TuanLinh05/antenna-fuzzy-control/3D Print/Antenna_TheGioiIC_v3/hardware_BOM.csv

category | item | sku | required | purchase | price | stock | minimum | multiple | url | notes | verified_date
mechanical | MG946R servo 180° + bộ tay đi kèm | IC373 | 1 | 1 | 98220 | 60 | 1 | 1 | https://www.thegioiic.com/mg946r-dong-co-servo-giam-toc-rc-180-do-rang-kim-loai-12-kg-cm-4-8-7-2-v | Thân 40×19×43 mm theo cửa hàng; dùng tay tròn và vít tâm trong bộ. Ảnh cửa hàng có các phụ kiện này; kiểm tra bộ nhận được. | 2026-10-24
mechanical | NEMA17 SL42STH40-1684A | IC5255 | 1 | 1 | 210900 | 1 | 1 | 1 | https://www.thegioiic.com/sl42sth40-1684a-dong-co-buoc-nema17-42x42mm-1-8-0-4nm | Trục Ø5, nhô 20 mm, thân dài 40 mm, 1,68 A/pha; mẫu lỗ gá 31 mm theo NEMA17 danh định. Tồn chỉ 1. | 2026-10-24
mechanical | Pulley GT2 20T, lỗ 5 mm, rãnh 7 mm | IC7387 | 1 | 1 | 11400 | 46 | 1 | 1 | https://www.thegioiic.com/gt2-banh-rang-puly-20-rang-buoc-2mm-ranh-day-dai-7mm-lo-5mm | Rãnh nhận đai 6 mm; căn giữa vùng răng tại Z=73 mm. Chiều dài dọc trục pulley chưa có bản vẽ đầy đủ. | 2026-10-24
mechanical | Dây vòng kín 2GT-280, rộng 6 mm | IC20188 | 1 | 1 | 17100 | 46 | 1 | 1 | https://www.thegioiic.com/2gt-280-day-dai-140-rang-buoc-2-0-rong-6mm | 280 mm / 140 răng / bước 2 mm. Đúng cấu hình CAD V2. | 2026-10-24
mechanical | Vòng bi 608ZZ 8×22×7 mm | IC15606 | 4 | 4 | 3420 | 1599 | 1 | 1 | https://www.thegioiic.com/608zz-bac-dan-vong-bi-trong-8mm-ngoai-22mm-day-7mm | 2 vòng bi phương vị và 2 vòng bi nâng; không đổi sang 688ZZ. | 2026-10-24
mechanical | Thanh trượt inox 304 Ø8×200 mm | IC17522 | 1 | 1 | 19753 | 49 | 1 | 1 | https://www.thegioiic.com/thanh-truot-8mm-dai-20cm-inox-304 | Cắt 120 +40 +30 mm; chừa tối đa 10 mm cho đường cắt và sửa đầu. Dũa mặt phẳng ở các vị trí truyền động theo hướng dẫn V3. | 2026-10-24
mechanical | Vít M4×20 DIN912 304 | IC10179 | 20 | 24 | 1368 | 3481 | 1 | 1 | https://www.thegioiic.com/oc-luc-giac-m4-x-20mm-din912-304 | Khung 20 vị trí, dùng lại ốc đang có nếu đúng M4x20 DIN912. Không cần mua dòng này nếu đã đủ. | 2026-10-24
mechanical | Vít M3×8 DIN912 304 | IC10152 | 4 | 10 | 650 | 3975 | 10 | 5 | https://www.thegioiic.com/oc-luc-giac-m3-x-8mm-din912-304 | Adapter ép trục 1; mặt encoder 3 kèm đệm in 1 mm, vào ren encoder 3 mm danh định. Kiểm tra chiều sâu ren thực. | 2026-10-24
mechanical | Vít M3×10 DIN912 304 | IC10153 | 6 | 10 | 673 | 16047 | 10 | 5 | https://www.thegioiic.com/oc-luc-giac-m3-x-10mm-din912-304 | Motor 4 kèm đệm in 1 mm; giá chảo ép trục 2. Tối thiểu 10, bội 5. | 2026-10-24
mechanical | Vít M3×12 DIN912 304 | IC10154 | 12 | 15 | 713 | 2150 | 10 | 5 | https://www.thegioiic.com/oc-luc-giac-m3-x-12mm-din912-304 | Chân đế 4; tai servo 4; ép trục rotor 1; hub đầu thu 3. Tối thiểu 10, bội 5. | 2026-10-24
mechanical | Vít M3×16 DIN912 304 | IC10155 | 6 | 10 | 866 | 9150 | 10 | 5 | https://www.thegioiic.com/oc-luc-giac-m3-x-16mm-din912-304 | Vòng chặn 2; gá encoder vào đế 4. | 2026-10-24
mechanical | Vít M3×20 DIN912 304 | IC10156 | 7 | 10 | 1083 | 4553 | 1 | 1 | https://www.thegioiic.com/oc-luc-giac-m3-x-20mm-din912-304 | Chảo vào giá 4; chân thanh đầu thu 3. Mua dư 3. | 2026-10-24
mechanical | Vít M2×10 DIN912 304 | IC10107 | 2 | 20 | 496 | 2280 | 20 | 10 | https://www.thegioiic.com/oc-luc-giac-m2-x-10mm-din912-304 | Ít nhất 2 lỗ đối xứng trên tay tròn servo. Tối thiểu 20, bội 10. | 2026-10-24
mechanical | Đai ốc thép M3 lục giác thường | IC9122 | 28 | 30 | 342 | 12903 | 20 | 10 | https://www.thegioiic.com/dai-oc-thep-m3 | 24 vị trí V2 +4 đai ốc dưới gá encoder. AF5.5 mm danh định. | 2026-10-24
mechanical | Đai ốc thép M4 lục giác thường | IC8318 | 20 | 30 | 388 | 363 | 20 | 10 | https://www.thegioiic.com/dai-oc-thep-m4 | AF danh định 7 mm; dày khoảng 3,2 mm. V2 không cần đai ốc mỏng. Tối thiểu 20, bội 10. | 2026-10-24
mechanical | Đai ốc đồng M2 lục giác | IC33241 | 2 | 10 | 570 | 265 | 10 | 5 | https://www.thegioiic.com/dai-oc-dong-m2 | Dùng cho adapter tay servo; CAD giả định AF 4 mm, dày ≤2,8 mm, cần đo thực. Tối thiểu 10, bội 5. | 2026-10-24
mechanical | Encoder LPD3806-600BM NPN 600P/R | IC3636 | 1 | 1 | 318060 | 123 | 1 | 1 | https://www.thegioiic.com/lpd3806-600bm-rotary-encoder-600-xung-npn-5-24vdc | Trục 6x13; thân D38; boss20x5; 3 lỗ M3 PCD28 hoặc30. Cấp5V; A/B kéo lên3.3V. Thân dài45mm là bao dự phòng, không phải kích thước nhà sản xuất. | 2026-10-24
mechanical | Khớp nối cứng D14 L25 lỗ6-8 | IC20164 | 1 | 1 | 11400 | 24 | 1 | 1 | https://www.thegioiic.com/khop-noi-truc-cung-dai-25mm-lo-truc-6-8 | Khớp đo encoder, không đỡ tải bàn xoay. Căn đồng tâm trước khi siết; vít hãm đi kèm cần kiểm tra khi nhận. | 2026-10-24
electrical | TB6600 driver stepper 42-57 4A | IC7010 | 1 | 1 | 116046 | 275 | 1 | 1 | https://www.thegioiic.com/tb6600-mach-dieu-khien-dong-co-buoc-42-57-4a | Cấp12V; chọn1/16 (3200 xung/vòng motor), bắt đầu mức dòng1.0A rồi thử tối đa1.5A theo bảng thực. Tín hiệu qua transistor, không nối3.3V trực tiếp vào opto5V. | 2026-10-24
electrical | Adapter kín 12V5A DC5525 | IC2723 | 1 | 1 | 83220 | 142 | 1 | 1 | https://www.thegioiic.com/nguon-adapter-12v-5a-dau-dc-5-5x2-5mm-dai-1m-co-led | Nguồn chính60W. Dùng jack cái5525 đúng2.5mm; đo cực tính trước khi đấu. | 2026-10-24
electrical | MP2482 module hạ áp 5V5A | IC19734 | 1 | 1 | 35340 | 292 | 1 | 1 | https://www.thegioiic.com/mp2482-mach-on-ap-5v-5a | Vào7-30V, ra5V theo cửa hàng. Nhánh servo và encoder, có tụ1000uF. 5A là mức công bố; kiểm tra sụt áp và nhiệt dưới tải thực. | 2026-10-24
electrical | 2N3904 NPN TO92 | IC2033 | 3 | 20 | 342 | 2260 | 20 | 10 | https://www.thegioiic.com/2n3904-transistor-npn-40v-0-2a-3-chan-to-92 | Ba kênh STEP, DIR, đệm servo. Tra đúng E/B/C theo datasheet ON Semiconductor; không suy ra từ hình vỏ. | 2026-10-24
electrical | Điện trở1k 1/4W 5% | IC921 | 5 | 50 | 55 | 18500 | 50 | 50 | https://www.thegioiic.com/dien-tro-1-kohm-1-4w-5-4-vong-mau | 3 điện trở base transistor; 2 nối tiếp A/B encoder. | 2026-10-24
electrical | Điện trở4k7 1/4W 5% | IC923 | 3 | 50 | 55 | 20350 | 50 | 50 | https://www.thegioiic.com/dien-tro-4-7-kohm-1-4w-5-4-vong-mau | 2 kéo A/B lên3.3V; 1 kéo tín hiệu servo lên5V. | 2026-10-24
electrical | Điện trở10k 1/4W 5% | IC925 | 3 | 50 | 55 | 10550 | 50 | 50 | https://www.thegioiic.com/dien-tro-10-kohm-1-4w-5-4-vong-mau | Base-emitter kéo xuống cho3 transistor. | 2026-10-24
electrical | Tụ hóa1000uF16V xuyên lỗ | IC4475 | 1 | 2 | 1596 | 271 | 1 | 1 | https://www.thegioiic.com/tu-hoa-1000uf-16v-8x16mm-xuyen-lo | Lắp song song5V/GND sát đầu cấp servo, đúng cực. Mua1 dự phòng. | 2026-10-24
electrical | Dây silicon18AWG đen | IC37942 | 2 | 2 | 15960 | 1706 | 1 | 1 | https://www.thegioiic.com/18awgx1-day-dien-silicon-chiu-nhiet-sieu-mem-mau-den-loai-tot | Đơn vị mét; dây GND nguồn, đi theo hình sao. | 2026-10-24
electrical | Dây silicon18AWG đỏ | IC37941 | 2 | 2 | 15960 | 372 | 1 | 1 | https://www.thegioiic.com/18awgx1-day-dien-silicon-chiu-nhiet-sieu-mem-mau-do-loai-tot | Đơn vị mét; nhánh12V/5V phân biệt và đánh dấu rõ. | 2026-10-24
electrical | PCB hàn test FR4 5x7cm | IC7157 | 1 | 1 | 6703 | 1825 | 1 | 1 | https://www.thegioiic.com/fr4-pcb-han-test-board-5x7cm-phu-xanh-1-mat | Hàn mạch đệm và phân phối tín hiệu. Nhánh công suất dùng dây đồng18AWG, không dùng pad mảnh làm đường dòng servo. | 2026-10-24
electrical | Hàng rào đực2.54mm40chân đồng mạ niken | IC22930 | 2 | 2 | 1596 | 2839 | 1 | 1 | https://www.thegioiic.com/hang-rao-duc-don-2-54mm-40-chan-1-hang-cao-11-2mm-xuyen-lo-chan-dong-ma-niken | Cắt header cho board và đầu servo. Hàn chắc các chân cấp nguồn. | 2026-10-24
electrical | Dây bẹ cái-cái30cm | IC2553 | 10 | 20 | 570 | 16880 | 10 | 10 | https://www.thegioiic.com/day-be-cai-cai-dai-30cm | Giá theo từng sợi; chỉ dùng cho tín hiệu và dòng nhỏ của MCU, không cấp dòng servo qua dây Dupont. | 2026-10-24
electrical | Jack DC5525 cái kèm domino | IC7741 | 1 | 1 | 4560 | 462 | 1 | 1 | https://www.thegioiic.com/dc5525-dau-noi-nguon-dc-cai-noi-day-kim-2-5mm-kem-domino | Khớp adapter5525; giữ lực kéo khỏi PCB, kiểm tra tiếp xúc và nhiệt khi chạy. | 2026-10-24
electrical | Domino KF128-2-V5mm10A | IC1167 | 6 | 8 | 2850 | 17832 | 1 | 1 | https://www.thegioiic.com/kf128-2-v-domino-2-chan-thang-5mm-300v-10a-han-pcb-loai-tot | Nguồn vào, nguồn5V, encoder và các đầu dây. Mua2 dự phòng. | 2026-10-24
electrical | CP2102 USB-TTL UART | IC3024 | 1 | 1 | 44460 | 578 | 1 | 1 | https://www.thegioiic.com/cp2102-mach-chuyen-doi-usb-to-ttl-uart | Nạp bằng bootloader UART hoặc ghi dữ liệu. TX/RX dùng mức3.3V; không cấp servo từ cổng này. Khi board đã cấp nguồn riêng chỉ nốiTX/RX/GND. | 2026-10-24
electrical | Ống co nhiệt4mm600V | IC2780 | 1 | 1 | 2394 | 2967 | 1 | 1 | https://www.thegioiic.com/ong-co-nhiet-4mm-600v | Đơn vị mét. Cách điện từng mối nối; dây servo cần nối dài bằng dây mềm và chừa vòng dây, không kéo căng dây300mm có sẵn. | 2026-10-24
