TuanLinh05/antenna-fuzzy-control/3D Print/Antenna_V4_MT6701/printed_parts.csv

part | quantity | X_mm | Y_mm | Z_mm | solid_volume_cm3
01_base | 1 | 208.0 | 146.0 | 8.0 | 234.034
02_azimuth_bearing_tower | 1 | 84.0 | 83.97 | 58.0 | 80.293
03_stepper_tension_bridge | 1 | 70.0 | 56.0 | 80.0 | 85.261
05_bearing_spacer | 3 | 11.5 | 11.5 | 2.0 | 0.102
04_GT2_80T_integrated_rotor | 1 | 96.0 | 95.97 | 37.0 | 88.799
07_fork_crossbeam | 1 | 208.0 | 60.0 | 8.0 | 91.831
08_right_bearing_arm | 1 | 136.0 | 60.0 | 32.0 | 88.353
09_left_bearing_arm | 1 | 136.0 | 60.0 | 32.0 | 87.312
10_LD1501MG_adjustable_carrier | 1 | 78.0 | 58.0 | 44.0 | 47.293
11_servo_horn_shaft_coupler | 1 | 36.0 | 35.99 | 18.0 | 6.959
12_parabolic_dish_160mm | 1 | 160.0 | 159.95 | 30.0 | 52.689
13_dish_cradle | 1 | 170.0 | 48.0 | 29.0 | 44.331
14_feed_strut | 3 | 75.0 | 62.0 | 8.0 | 3.747
15_feed_hub | 1 | 28.0 | 28.0 | 24.0 | 5.938
16_608_fit_coupon | 1 | 84.0 | 30.0 | 9.0 | 14.238
17_shaft_fit_coupon | 1 | 42.0 | 16.0 | 8.0 | 4.109
18_printed_split_shaft_collar | 2 | 25.0 | 24.0 | 8.0 | 3.058
19_bolted_printed_foot | 4 | 32.0 | 31.99 | 55.0 | 39.047
20_LD1501MG_mount_fit_gauge | 1 | 56.0 | 70.0 | 4.0 | 11.417
21_M3_motor_screw_washer_1mm | 4 | 8.0 | 8.0 | 1.0 | 0.042
22_MT6701_fixed_bridge | 1 | 80.0 | 64.0 | 40.0 | 40.518
24_MT6701_XYZ_carrier | 1 | 44.38 | 44.38 | 6.7 | 2.978
25_rotating_4x2_magnet_cap | 1 | 23.0 | 19.99 | 14.0 | 3.437
26_MT6701_PCB_fit_gauge | 1 | 28.0 | 28.0 | 1.0 | 0.515
27_4mm_magnet_fit_gauge | 1 | 32.0 | 15.0 | 5.0 | 2.313
28_motor_shaft_fit_gauge | 1 | 44.0 | 18.0 | 5.0 | 3.678
29_servo_ear_0p5mm_spacer | 4 | 6.2 | 6.2 | 0.5 | 0.011
30_NEMA17_mount_fit_gauge | 1 | 50.0 | 50.0 | 2.0 | 3.395
23_D_shaft_fit_gauge | 1 | 38.0 | 20.0 | 8.0 | 5.253
