TuanLinh05/antenna-fuzzy-control/Review_2026-10-24/test_matrix.csv

id | phase | test | input | measure | proposed_acceptance | status
E01 | electrical | Driver_supply | Verify_TB6600_label_and_measure_12V_bus | Driver_voltage_and_fault | 12V_within_exact_module_range_and_no_supply_droop_fault | NOT_RUN
E02 | electrical | Servo_supply | Small_moves_near_calibrated_neutral | Servo_voltage_droop_and_peak_current | Within_6_to_8p4V_and_supply_thermal_budget | NOT_RUN
I01 | identification | Motor_and_step_scale | Known_small_pulse_count_in_both_directions | Actual_angle_per_pulse_and_rotation_sign | Consistent_with_verified_step_angle_microstep_and_ratio | NOT_RUN
I02 | identification | Azimuth_MT6701_calibration | Independent_known_angle_marks_in_both_directions | Offset_scale_nonlinearity_and_repeatability | Report_calibration_error_before_tracking_claim | NOT_RUN
I03 | identification | Azimuth_backlash | Approach_same_target_from_both_directions | Output_angle_and_pulse_dead_travel | Record_measured_backlash_for_model | NOT_RUN
I04 | identification | Servo_calibration_under_load | Small_PWM_steps_with_dish_and_external_angle_reference | Final_angle_and_direction_bias_dynamic_metrics_only_if_recorded | Calibration_map_and_separate_validation_points | NOT_RUN
C01 | tracking | Azimuth_small_steps | 0_to_1_to_minus1_to_0_deg | Absolute_error_and_hunting | Final_2s_error_le_0p5deg_and_no_sustained_hunting | NOT_RUN
C02 | tracking | Azimuth_large_steps | 0_to_30_to_minus30_to_0_deg | Overshoot_Ts2percent_TsAbsolute_speed | Final_error_le_0p5deg_report_POT_target_2percent | NOT_RUN
C03 | tracking | Elevation_servo_positions | Calibrated_servo_commands_75_90_105_deg | Final_elevation_by_external_reference_NOT_PWM_as_measurement | Proposed_error_le_1deg_subject_to_reference_uncertainty | NOT_RUN
C04 | tracking | Both_axes_together | Same_targets_as_C02_C03_with_synchronized_changes | Logged_azimuth_and_external_final_elevation | Azimuth_criteria_and_external_elevation_check_no_fault | NOT_RUN
C05 | tracking | Repeated_bidirectional_targets | Repeat_same_targets_5_times | Final_error_mean_std_range_and_direction_bias | Publish_all_runs_and_max_min | NOT_RUN
C06 | comparison | Same_plant_baselines | Open_loop_or_servo_default_then_tuned_PD_then_fuzzy | Same_metrics_limits_load_and_reference | Fair_budget_no_requirement_that_fuzzy_wins | NOT_RUN
C07 | tracking | Moving_reference | Low_rate_bounded_ramp_then_sine | RMSE_phase_lag_and_speed | Set_tracking_limits_after_identification | NOT_RUN
R01 | robustness | Load_variation | Known_light_load_change_with_base_secured | Error_speed_and_current | Within_validated_mechanical_and_electrical_range | NOT_RUN
R02 | simulation | Missed_pulses | Drop_known_pulse_fraction | Recovery_error_and_fault | Report_command_loss_separately_from_rotor_slip | NOT_RUN
F01 | fault | Heartbeat_loss | Stop_heartbeat_without_reset | Time_to_fault_and_last_command | Firmware_timeout_and_motion_stop_verified | NOT_RUN
F02 | fault | Azimuth_sensor_stale_or_invalid | Inject_stale_MT6701_data_or_I2C_error_in_software | Data_age_fault_and_command_stop | Fault_within_configured_data_age_limit | NOT_RUN
F03 | fault | Out_of_range_command | Send_goal_outside_calibrated_travel | Rejection_and_no_new_motion | Reject_goal_and_preserve_defined_fault_policy | NOT_RUN
S01 | simulation | Jam_release_and_shock | Existing_jam_and_0p08Nm_simulation_only | True_peak_speed_and_tracking_failure | Observation_only_no_hardware_blocking_test | NOT_RUN
