TuanLinh05/antenna-fuzzy-control/3D Print/Antenna_TheGioiIC_v3/STEP/ASSEMBLY_with_hardware_envelopes.step

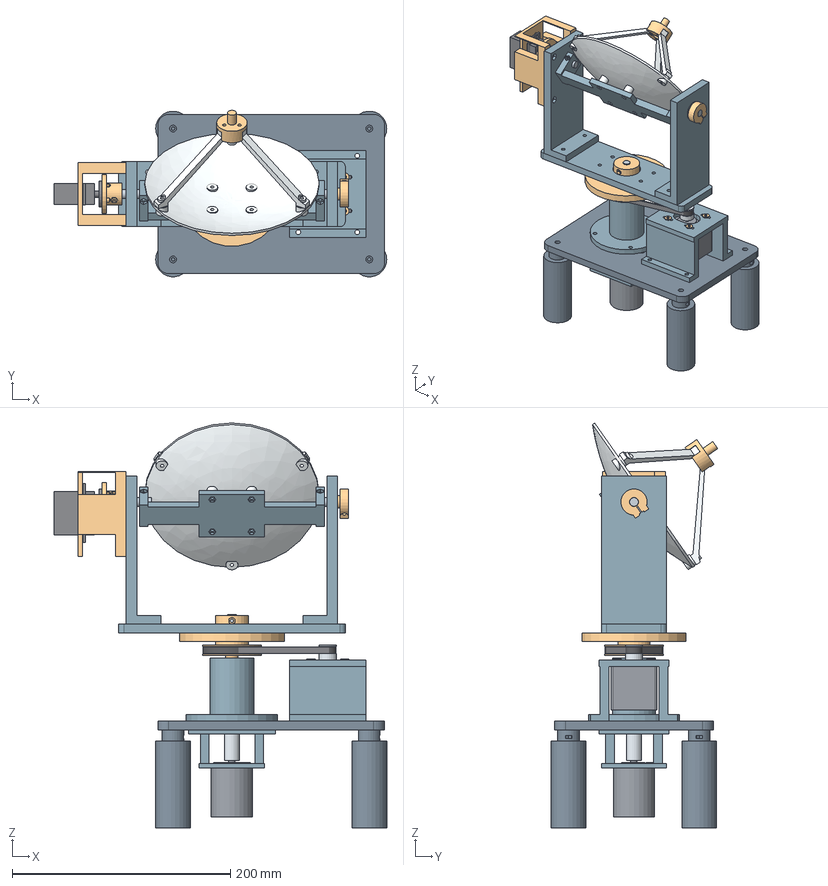
[picture p3: CAD file, 2026-10-25]
3D Print/Antenna_TheGioiIC_v3/STEP/ASSEMBLY_with_hardware_envelopes.step
305.0 x 152.7 x 371.4 mm
01_base
02_azimuth_bearing_tower
03_stepper_tension_bridge
upper_bearing_spacer
lower_bearing_spacer
right_elevation_inner_race_spacer
04_GT2_80T_integrated_rotor
07_fork_crossbeam
08_right_bearing_arm
09_left_bearing_arm
10_MG946R_short_screw_carrier
11_servo_horn_shaft_coupler
12_parabolic_dish_160mm
13_dish_cradle
feed_strut_90
feed_strut_210
feed_strut_330
15_feed_hub
printed_azimuth_lower_collar
printed_right_elevation_collar
printed_foot_-54_-60
printed_foot_-54_60
printed_foot_126_-60
printed_foot_126_60
motor_screw_washer_-15.5_-15.5
motor_screw_washer_-15.5_15.5
motor_screw_washer_15.5_-15.5
motor_screw_washer_15.5_15.5
22_output_encoder_bracket
encoder_screw_washer_90
encoder_screw_washer_210
encoder_screw_washer_330
608_az_8
608_az_59
azimuth_8mm_shaft_120mm_D_flat
608_elevation_-97
608_elevation_90
left_8mm_shaft_40mm_D_flats
right_8mm_shaft_30mm_D_flat
LPD3806_600BM_clearance_envelope
D14L25_6_8_encoder_coupling_envelope
SL42STH40_1684A_envelope
GT2_20T_metal_pulley_ENVELOPE
MG946R_nominal_envelope
MG946R_supplied_round_horn_envelope
GT2_280mm_belt_PITCH_ENVELOPE
