TuanLinh05/antenna-fuzzy-control/3D Print/Antenna_TheGioiIC_v3/3MF_plates/Plate_05_encoder_and_D_shaft_gauge.3mf

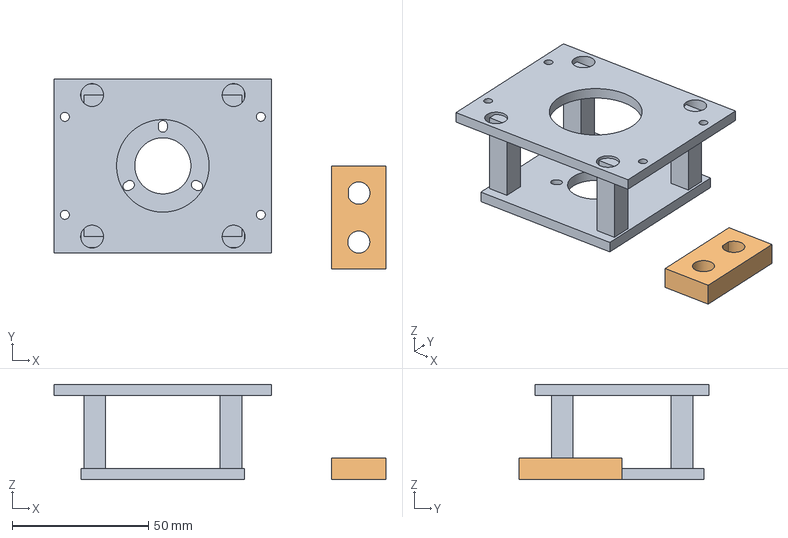
[picture p6: CAD file, 2026-10-25]
3D Print/Antenna_TheGioiIC_v3/3MF_plates/Plate_05_encoder_and_D_shaft_gauge.3mf
122.0 x 70.0 x 35.0 mm
22_output_encoder_bracket
23_D_shaft_fit_gauge
