TuanLinh05/antenna-fuzzy-control/3D Print/Antenna_TheGioiIC_v3/STEP/04_GT2_80T_integrated_rotor.step

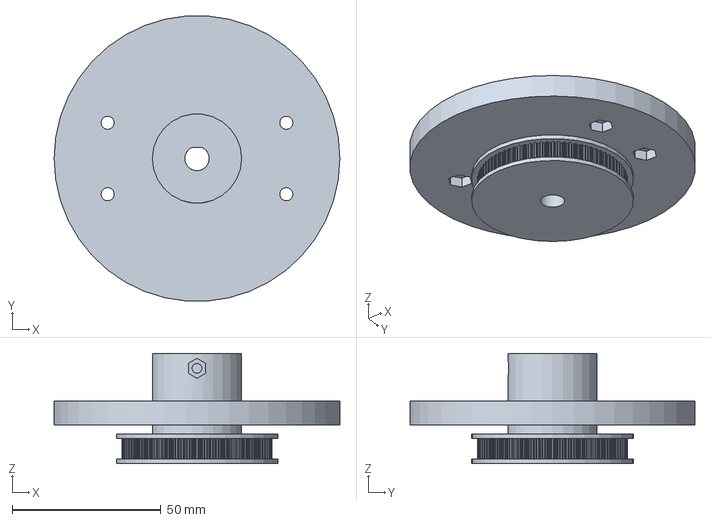
[picture p7: CAD file, 2026-10-25]
3D Print/Antenna_TheGioiIC_v3/STEP/04_GT2_80T_integrated_rotor.step
96.0 x 95.7 x 37.0 mm
