TuanLinh05/antenna-fuzzy-control/3D Print/Antenna_V4_MT6701/3MF_plates/Plate_02_dish_cradle_feed_arms.3mf

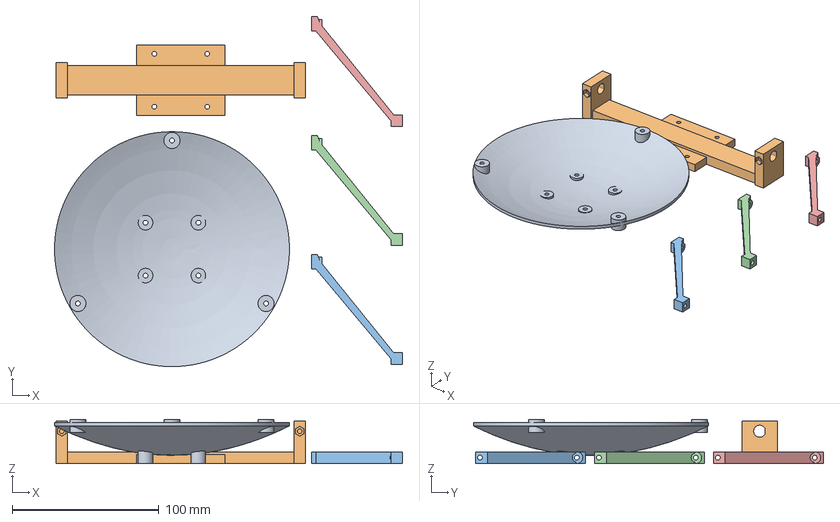
[picture p8: CAD file, 2026-10-25]
3D Print/Antenna_V4_MT6701/3MF_plates/Plate_02_dish_cradle_feed_arms.3mf
237.0 x 238.5 x 30.0 mm
12_parabolic_dish_160mm
13_dish_cradle
14_feed_strut x 3
