TuanLinh05/antenna-fuzzy-control/3D Print/Antenna_V4_MT6701/STEP/01_base.step

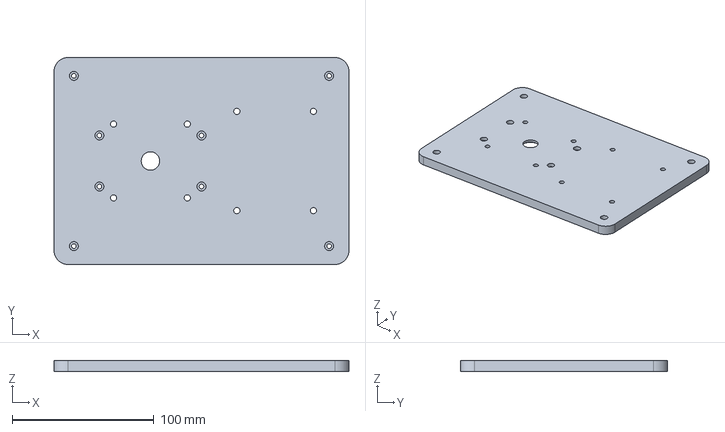
[picture p9: CAD file, 2026-10-25]
3D Print/Antenna_V4_MT6701/STEP/01_base.step
208.0 x 146.0 x 8.00 mm
