TuanLinh05/antenna-fuzzy-control/3D Print/Antenna_V5_Reinforced/3MF_A1_PETG_0p4/Plate_03_drive_and_servo_mounts_A1_PETG_0p4.3mf

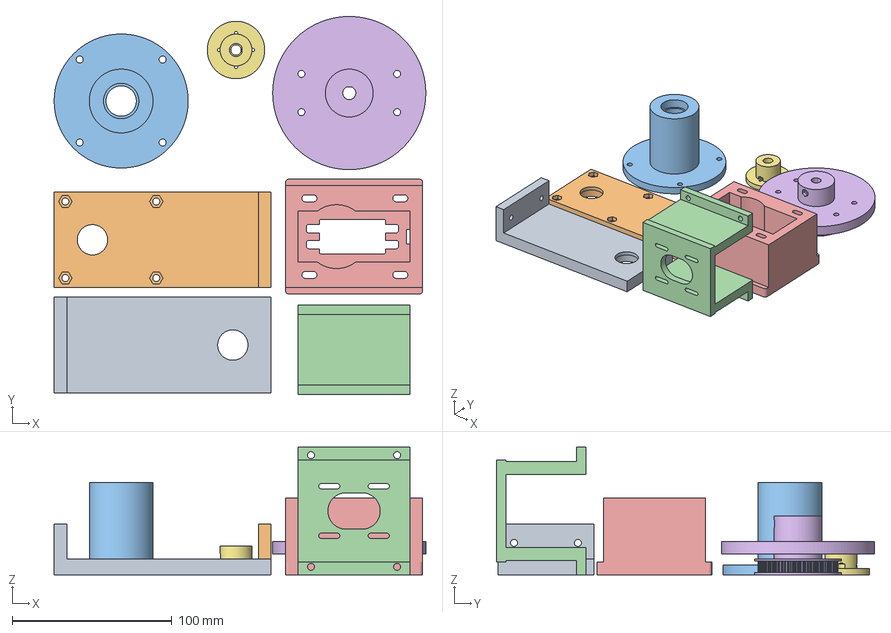
[picture p10: CAD file, 2026-10-25]
3D Print/Antenna_V5_Reinforced/3MF_A1_PETG_0p4/Plate_03_drive_and_servo_mounts_A1_PETG_0p4.3mf
233.0 x 237.0 x 80.0 mm
08_right_bearing_arm
09_left_bearing_arm
02_azimuth_bearing_tower
03_stepper_tension_bridge
10_LD1501MG_reinforced_carrier
04_GT2_80T_integrated_rotor
11_servo_horn_shaft_coupler
