TuanLinh05/antenna-fuzzy-control/3D Print/Antenna_V5_Reinforced/reference/V4_servo_carrier.step

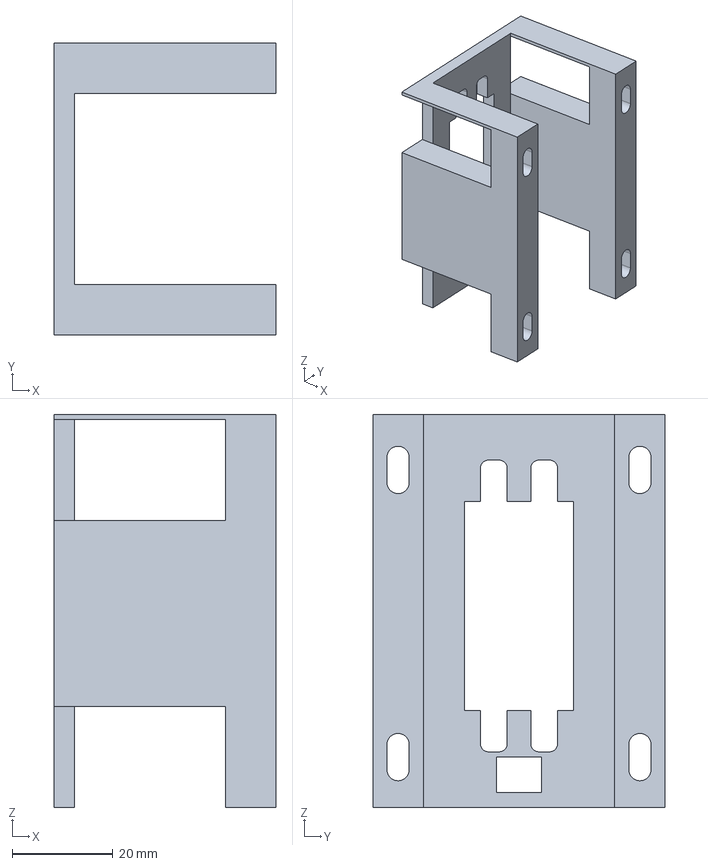
[picture p11: CAD file, 2026-10-25]
3D Print/Antenna_V5_Reinforced/reference/V4_servo_carrier.step
44.0 x 58.0 x 78.0 mm
