TuanLinh05/antenna-fuzzy-control/3D Print/Antenna_V5_Reinforced/STEP/23_D_shaft_fit_gauge.step

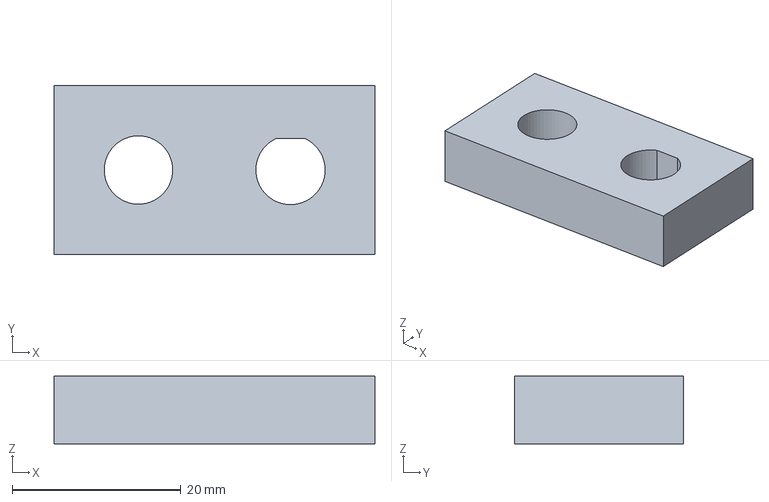
[picture p12: CAD file, 2026-10-25]
3D Print/Antenna_V5_Reinforced/STEP/23_D_shaft_fit_gauge.step
38.0 x 20.0 x 8.00 mm
