TuanLinh05/antenna-fuzzy-control/3D Print/de-mt6701-lap-thu-v1.3mf

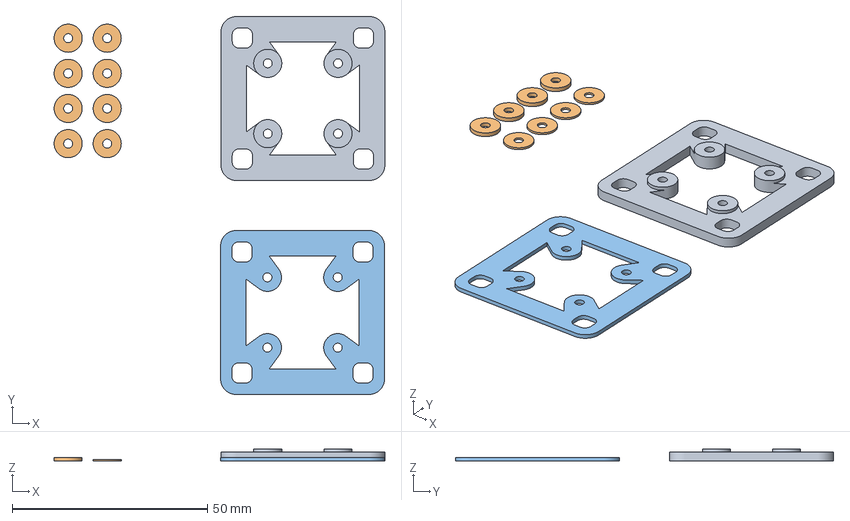
[picture p13: CAD file, 2026-10-25]
3D Print/de-mt6701-lap-thu-v1.3mf
84.7 x 96.8 x 3.20 mm
de-mt6701-lap-thu-v1.stl
dem-0p5-va-1mm-4-bo.stl
duong-kiem-lo-1mm.stl
