TuanLinh05/antenna-fuzzy-control/3D Print/Antenna_TheGioiIC_v3/3MF_plates/Plate_01_base_crossbeam.3mf

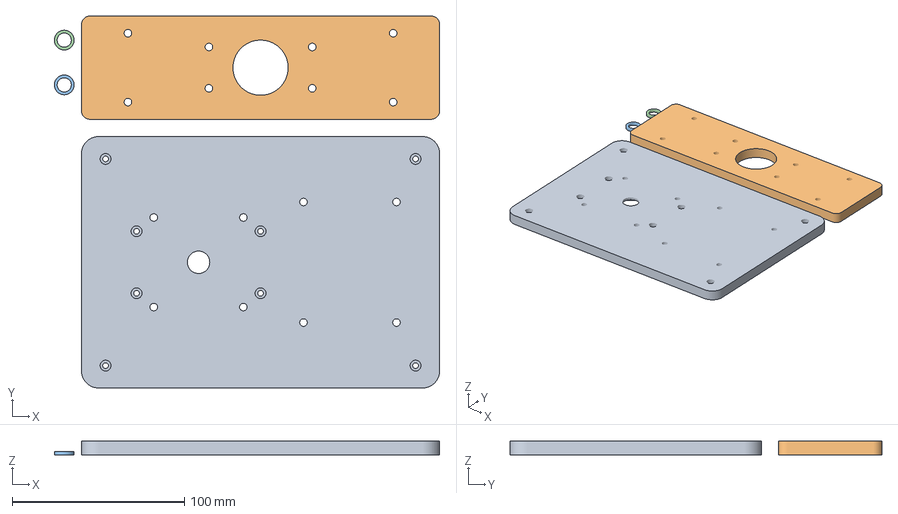
[picture p14: CAD file, 2026-10-25]
3D Print/Antenna_TheGioiIC_v3/3MF_plates/Plate_01_base_crossbeam.3mf
223.8 x 216.0 x 8.00 mm
01_base
07_fork_crossbeam
05_bearing_spacer x 2
