TuanLinh05/antenna-fuzzy-control/3D Print/Antenna_TheGioiIC_v3/STEP/15_feed_hub.step

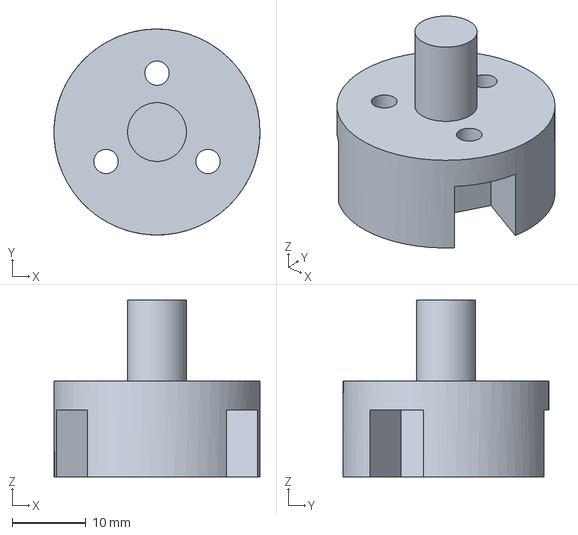
[picture p15: CAD file, 2026-10-25]
3D Print/Antenna_TheGioiIC_v3/STEP/15_feed_hub.step
28.0 x 28.0 x 24.0 mm
