TuanLinh05/antenna-fuzzy-control/3D Print/Antenna_V4_MT6701/3MF_plates/Plate_04_fit_test_and_feed_hub.3mf

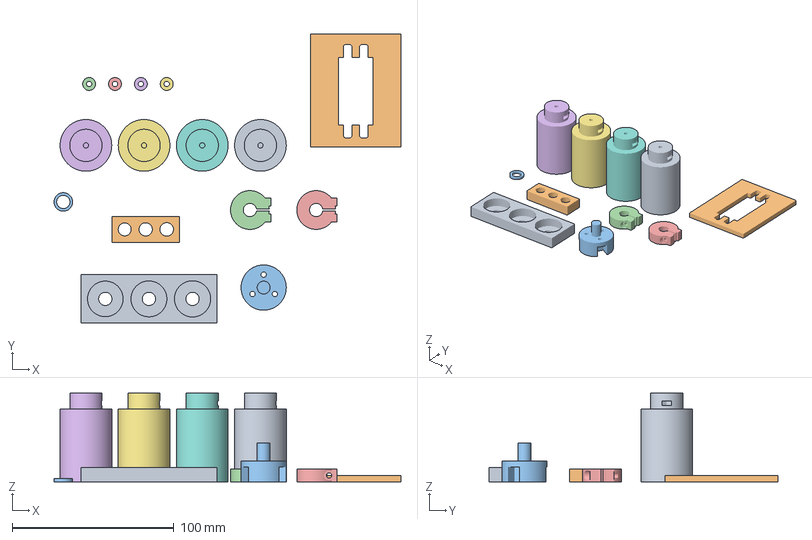
[picture p16: CAD file, 2026-10-25]
3D Print/Antenna_V4_MT6701/3MF_plates/Plate_04_fit_test_and_feed_hub.3mf
214.8 x 179.0 x 55.0 mm
16_608_fit_coupon
17_shaft_fit_coupon
15_feed_hub
18_printed_split_shaft_collar x 2
19_bolted_printed_foot x 4
20_LD1501MG_mount_fit_gauge
05_bearing_spacer
21_M3_motor_screw_washer_1mm x 4
