TuanLinh05/antenna-fuzzy-control/3D Print/Antenna_V4_MT6701/STEP/29_servo_ear_0p5mm_spacer.step

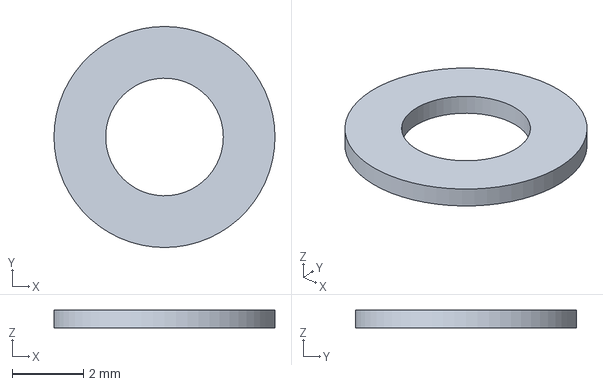
[picture p17: CAD file, 2026-10-25]
3D Print/Antenna_V4_MT6701/STEP/29_servo_ear_0p5mm_spacer.step
6.20 x 6.20 x 0.5 mm
