TuanLinh05/antenna-fuzzy-control/3D Print/Antenna_V5_Reinforced/3MF_A1_PETG_0p4/Plate_04_fit_test_and_feed_hub_A1_PETG_0p4.3mf

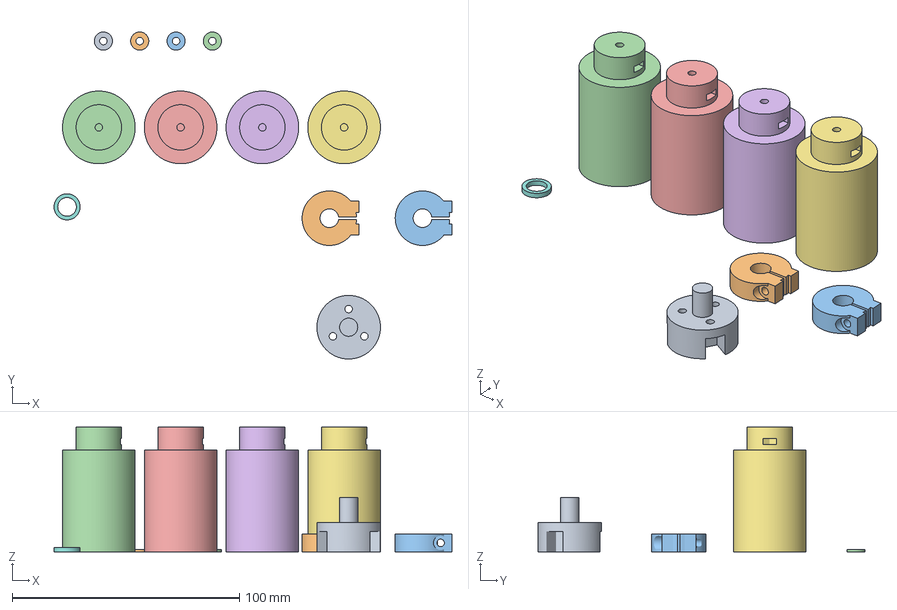
[picture p18: CAD file, 2026-10-25]
3D Print/Antenna_V5_Reinforced/3MF_A1_PETG_0p4/Plate_04_fit_test_and_feed_hub_A1_PETG_0p4.3mf
175.2 x 144.0 x 55.0 mm
15_feed_hub
18_printed_split_shaft_collar x 2
19_bolted_printed_foot x 4
05_bearing_spacer
21_M3_motor_screw_washer_1mm x 4
