TuanLinh05/antenna-fuzzy-control/3D Print/Antenna_V5_Reinforced/STEP/17_shaft_fit_coupon.step

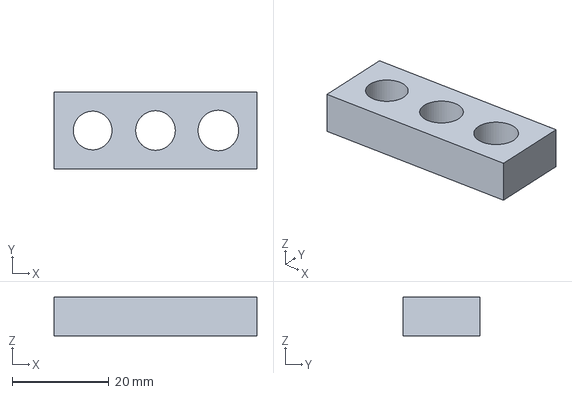
[picture p20: CAD file, 2026-10-25]
3D Print/Antenna_V5_Reinforced/STEP/17_shaft_fit_coupon.step
42.0 x 16.0 x 8.00 mm
