TuanLinh05/antenna-fuzzy-control/3D Print/duong-lo-bo-v2-1mm.3mf

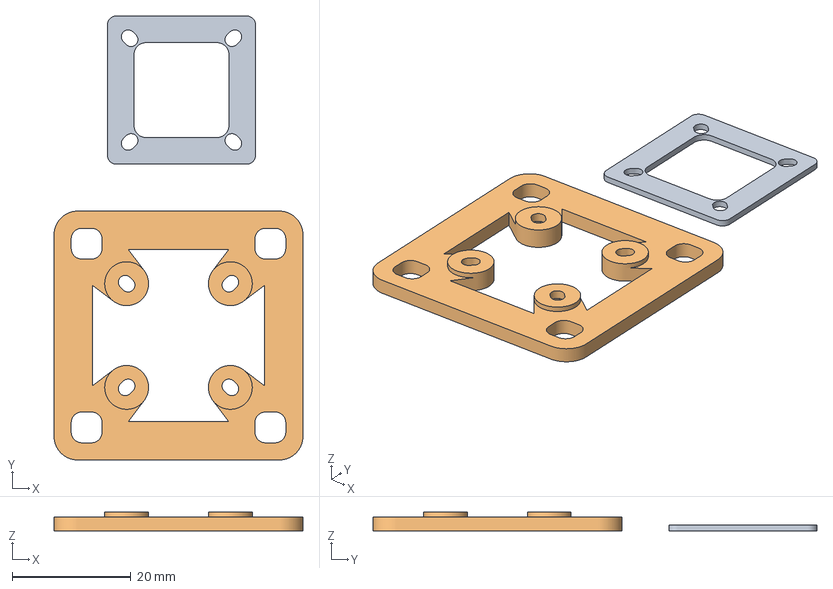
[picture p21: CAD file, 2026-10-25]
3D Print/duong-lo-bo-v2-1mm.3mf
42.0 x 74.9 x 3.20 mm
duong-lo-bo-v2-1mm.stl
de-mt6701-v2-lo-bo-chinh.stl
