TuanLinh05/antenna-fuzzy-control/3D Print/Antenna_TheGioiIC_v3/STEP/18_printed_split_shaft_collar.step

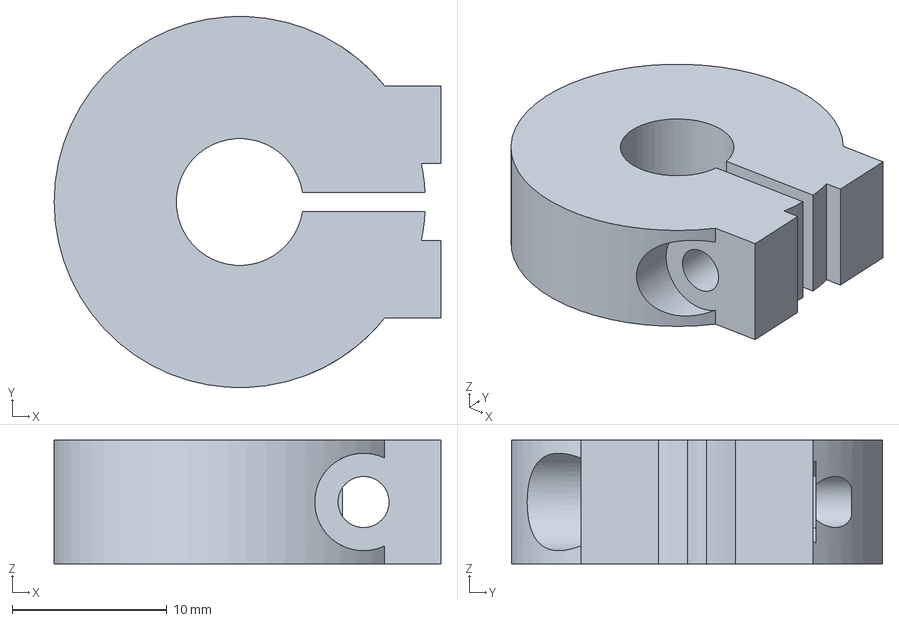
[picture p23: CAD file, 2026-10-25]
3D Print/Antenna_TheGioiIC_v3/STEP/18_printed_split_shaft_collar.step
25.0 x 24.0 x 8.00 mm
