TuanLinh05/antenna-fuzzy-control/3D Print/Antenna_V4_MT6701/STEP/26_MT6701_PCB_fit_gauge.step

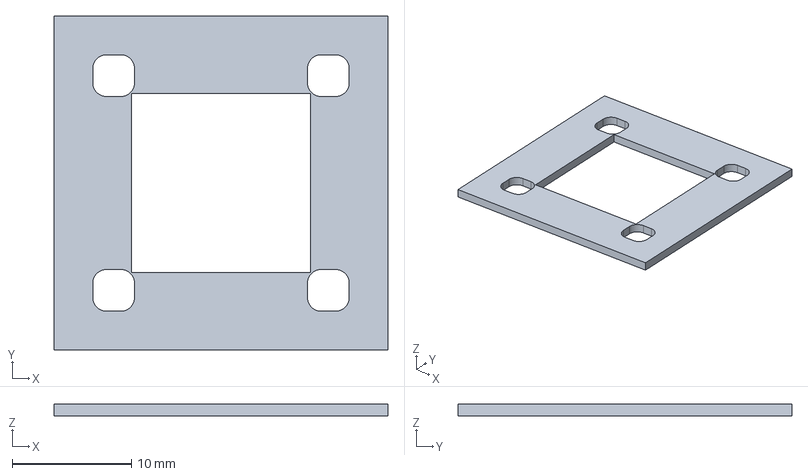
[picture p24: CAD file, 2026-10-25]
3D Print/Antenna_V4_MT6701/STEP/26_MT6701_PCB_fit_gauge.step
28.0 x 28.0 x 1.00 mm
