TuanLinh05/antenna-fuzzy-control/3D Print/Antenna_V5_Reinforced/3MF_A1_PETG_0p4/Plate_05_MT6701_and_fit_gauges_A1_PETG_0p4.3mf

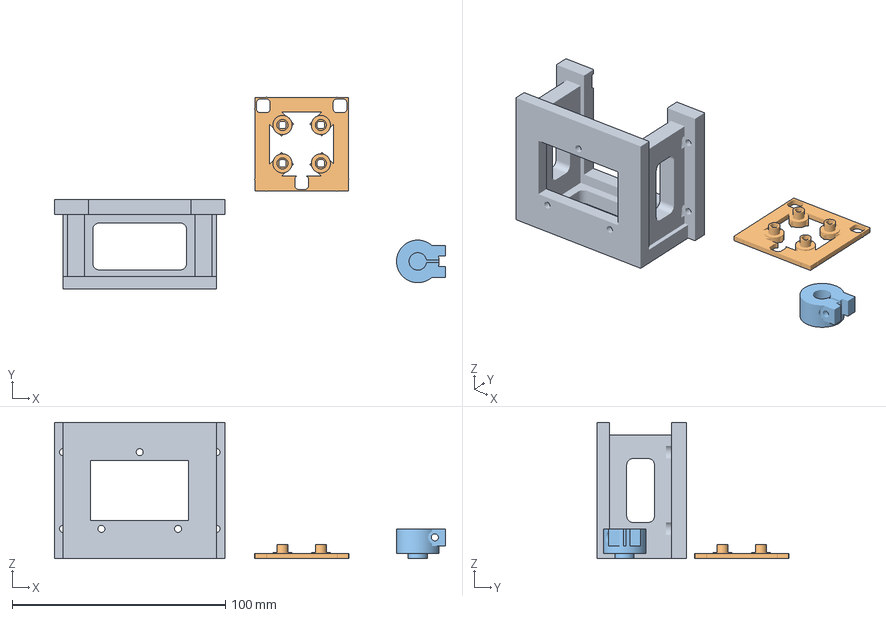
[picture p25: CAD file, 2026-10-25]
3D Print/Antenna_V5_Reinforced/3MF_A1_PETG_0p4/Plate_05_MT6701_and_fit_gauges_A1_PETG_0p4.3mf
183.5 x 90.2 x 64.0 mm
22_MT6701_open_U_bridge
24_MT6701_3point_carrier
25_rotating_4x2_magnet_cap
