TuanLinh05/antenna-fuzzy-control/3D Print/Antenna_V5_Reinforced/STEP/22_MT6701_open_U_bridge.step

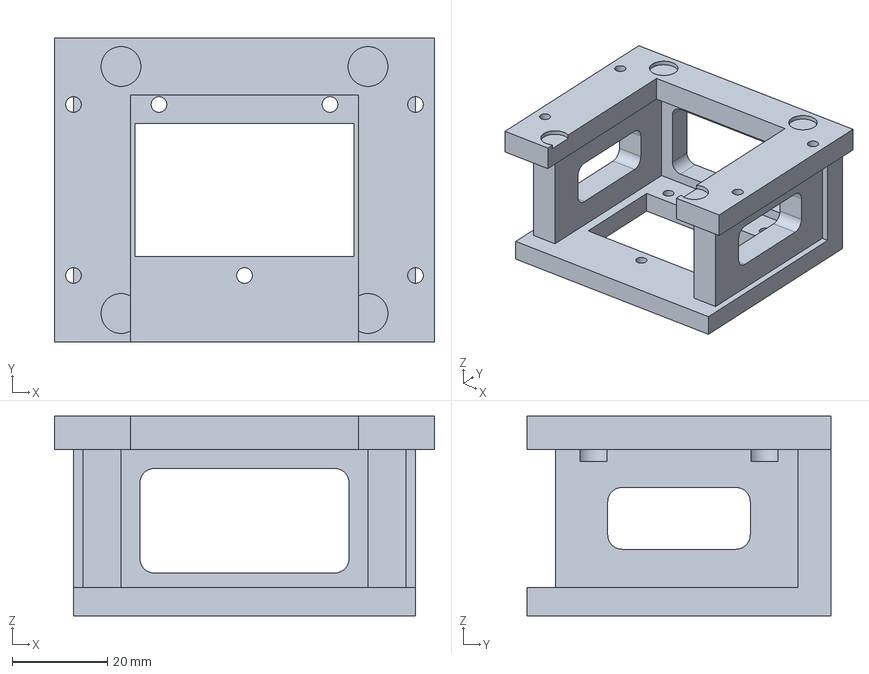
[picture p26: CAD file, 2026-10-25]
3D Print/Antenna_V5_Reinforced/STEP/22_MT6701_open_U_bridge.step
80.0 x 64.0 x 42.0 mm
