TuanLinh05/antenna-fuzzy-control/3D Print/Antenna_V4_MT6701/3MF_plates/Plate_05_MT6701_and_fit_gauges.3mf

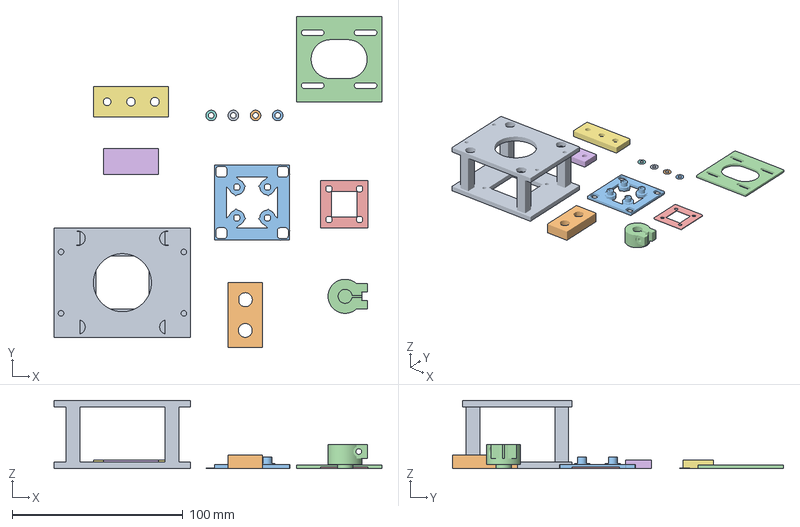
[picture p28: CAD file, 2026-10-25]
3D Print/Antenna_V4_MT6701/3MF_plates/Plate_05_MT6701_and_fit_gauges.3mf
192.0 x 194.0 x 40.0 mm
22_MT6701_fixed_bridge
23_D_shaft_fit_gauge
24_MT6701_XYZ_carrier
25_rotating_4x2_magnet_cap
26_MT6701_PCB_fit_gauge
27_4mm_magnet_fit_gauge
28_motor_shaft_fit_gauge
29_servo_ear_0p5mm_spacer x 4
30_NEMA17_mount_fit_gauge
