TuanLinh05/antenna-fuzzy-control/3D Print/Antenna_V4_MT6701/STEP/03_stepper_tension_bridge.step

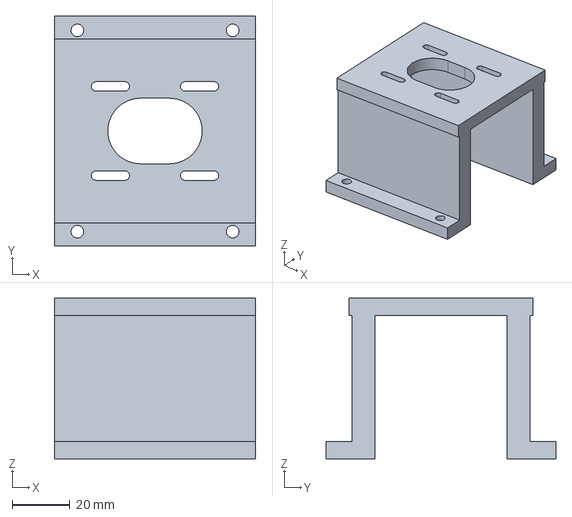
[picture p29: CAD file, 2026-10-25]
3D Print/Antenna_V4_MT6701/STEP/03_stepper_tension_bridge.step
70.0 x 80.0 x 56.0 mm
