TuanLinh05/antenna-fuzzy-control/3D Print/Antenna_V5_Reinforced/STEP/24_MT6701_3point_carrier.step

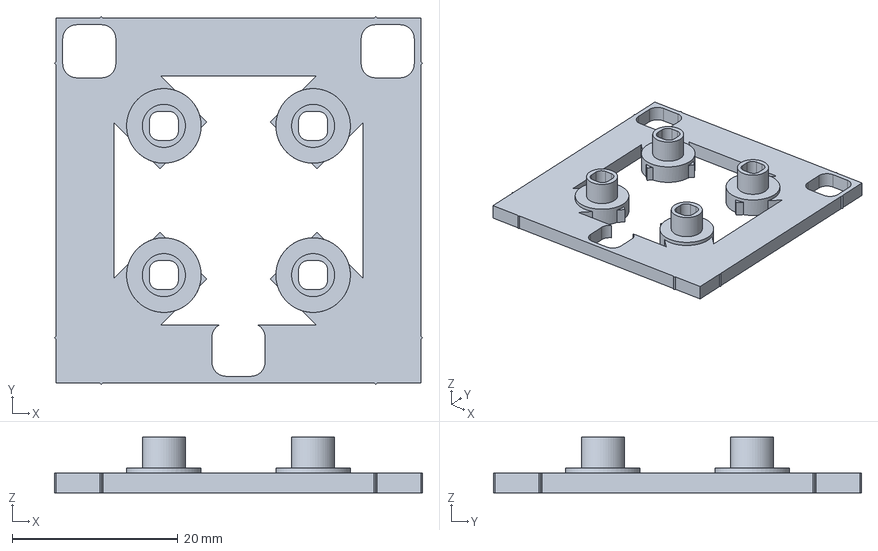
[picture p30: CAD file, 2026-10-25]
3D Print/Antenna_V5_Reinforced/STEP/24_MT6701_3point_carrier.step
44.4 x 44.4 x 6.70 mm
