TuanLinh05/antenna-fuzzy-control/3D Print/Antenna_V4_MT6701/STEP/09_left_bearing_arm.step

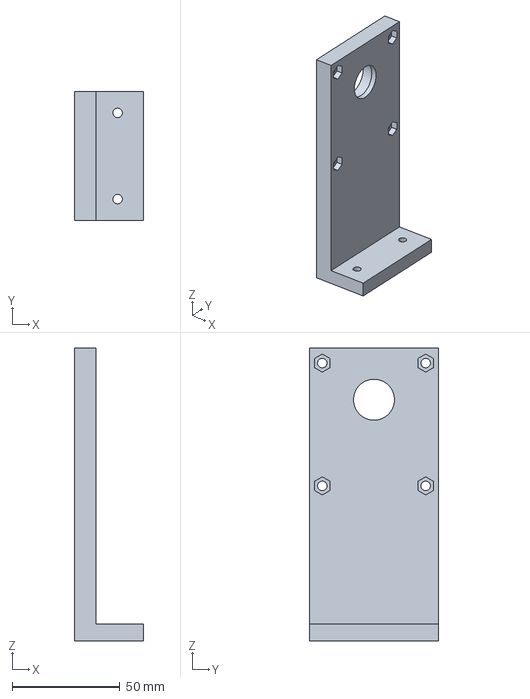
[picture p31: CAD file, 2026-10-25]
3D Print/Antenna_V4_MT6701/STEP/09_left_bearing_arm.step
32.0 x 60.0 x 136.0 mm
