TuanLinh05/antenna-fuzzy-control/3D Print/Antenna_V5_Reinforced/3MF_A1_PETG_0p4/Plate_00_CALIBRATION_FIRST_A1_PETG_0p4.3mf

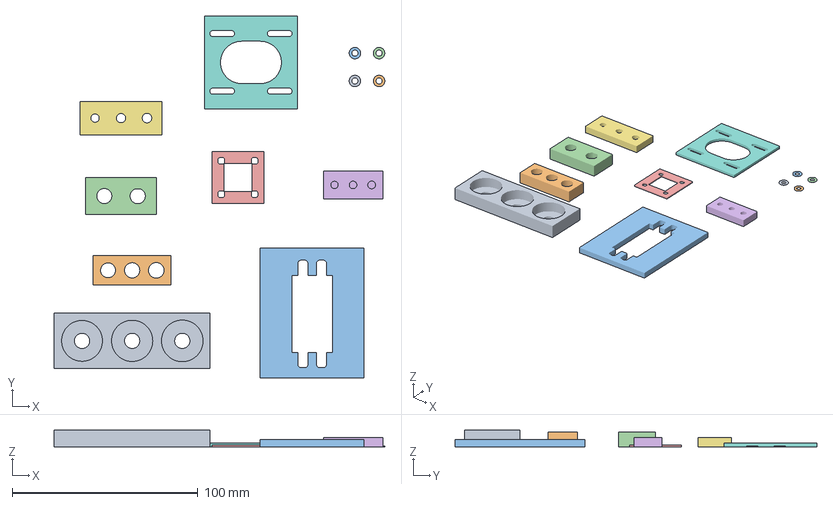
[picture p32: CAD file, 2026-10-25]
3D Print/Antenna_V5_Reinforced/3MF_A1_PETG_0p4/Plate_00_CALIBRATION_FIRST_A1_PETG_0p4.3mf
178.1 x 195.0 x 9.00 mm
16_608_fit_coupon
17_shaft_fit_coupon
20_LD1501MG_mount_fit_gauge
23_D_shaft_fit_gauge
26_MT6701_PCB_fit_gauge
27_4mm_magnet_fit_gauge
28_motor_shaft_fit_gauge
30_NEMA17_mount_fit_gauge
29_servo_ear_0p5mm_spacer x 4
