TuanLinh05/antenna-fuzzy-control/3D Print/Antenna_V5_Reinforced/STEP/05_bearing_spacer.step

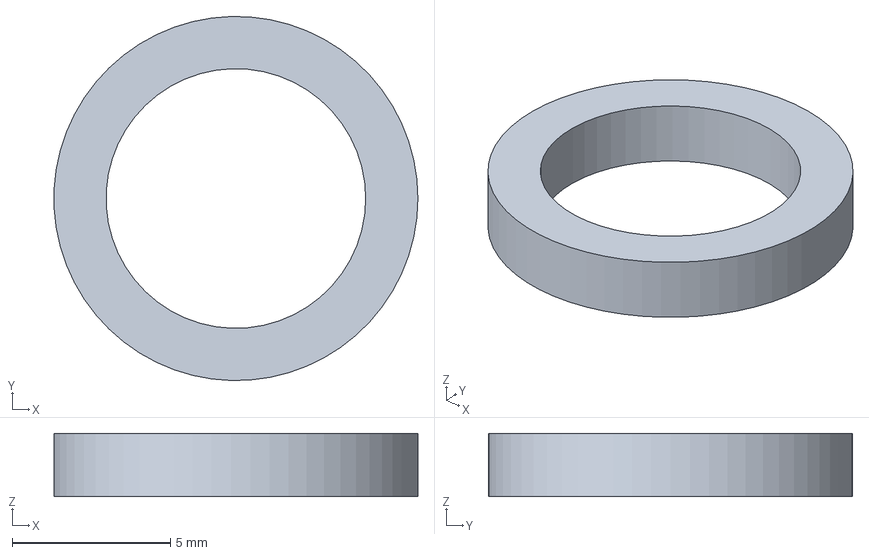
[picture p33: CAD file, 2026-10-25]
3D Print/Antenna_V5_Reinforced/STEP/05_bearing_spacer.step
11.5 x 11.5 x 2.00 mm
