TuanLinh05/antenna-fuzzy-control/3D Print/Antenna_V4_MT6701/STEP/14_feed_strut.step

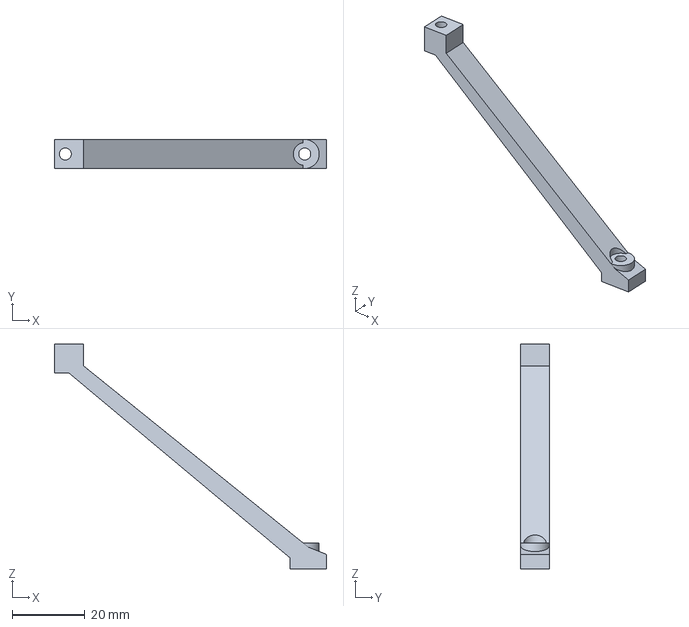
[picture p34: CAD file, 2026-10-25]
3D Print/Antenna_V4_MT6701/STEP/14_feed_strut.step
75.0 x 8.00 x 62.0 mm
