TuanLinh05/antenna-fuzzy-control/3D Print/Antenna_TheGioiIC_v3/STEP/07_fork_crossbeam.step

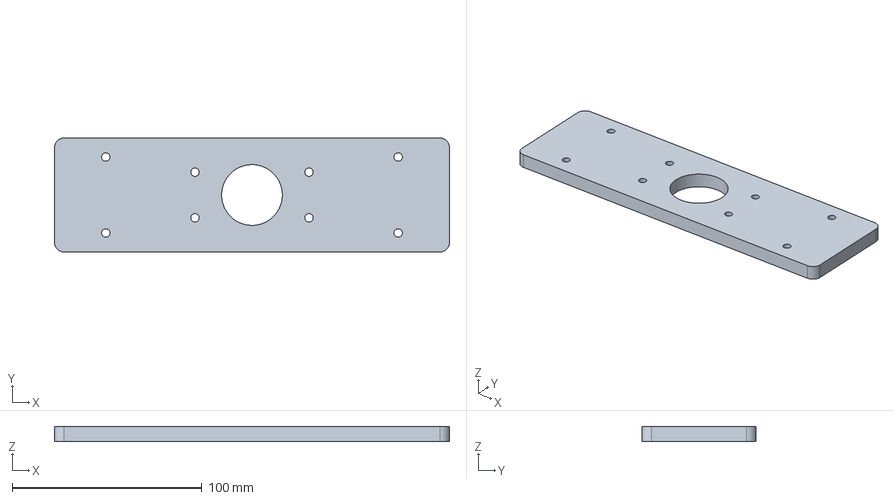
[picture p35: CAD file, 2026-10-25]
3D Print/Antenna_TheGioiIC_v3/STEP/07_fork_crossbeam.step
208.0 x 60.0 x 8.00 mm
