TuanLinh05/antenna-fuzzy-control/3D Print/Antenna_V4_MT6701/STEP/13_dish_cradle.step

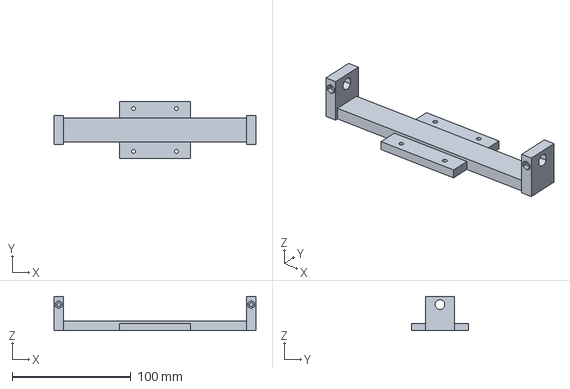
[picture p36: CAD file, 2026-10-25]
3D Print/Antenna_V4_MT6701/STEP/13_dish_cradle.step
170.0 x 48.0 x 29.0 mm
