TuanLinh05/antenna-fuzzy-control/3D Print/Antenna_V5_Reinforced/STEP/10_LD1501MG_reinforced_carrier.step

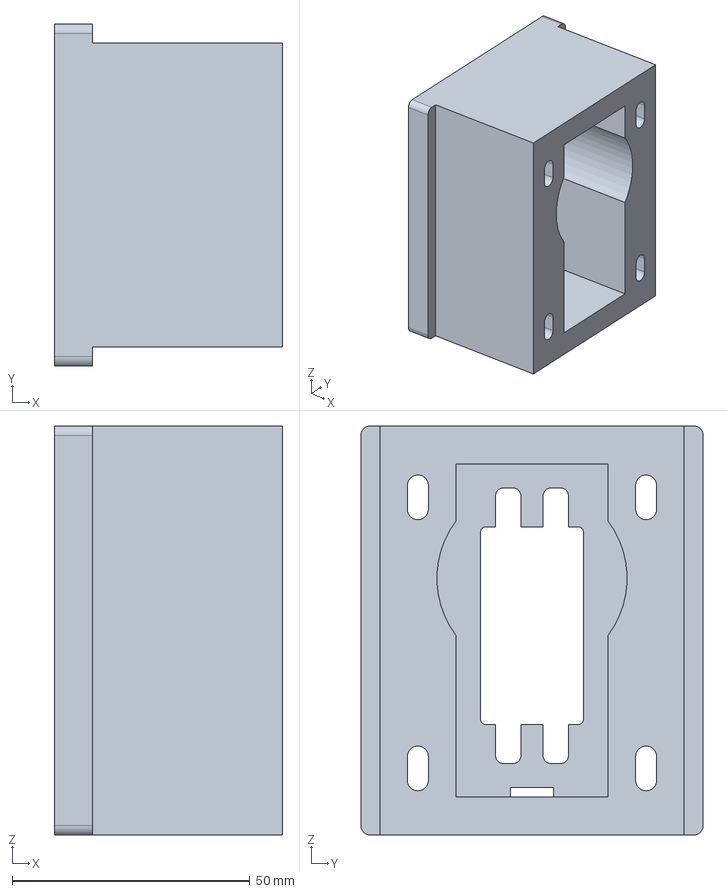
[picture p37: CAD file, 2026-10-25]
3D Print/Antenna_V5_Reinforced/STEP/10_LD1501MG_reinforced_carrier.step
48.0 x 72.0 x 86.0 mm
