TuanLinh05/antenna-fuzzy-control/3D Print/Antenna_TheGioiIC_v3/STEP/02_azimuth_bearing_tower.step

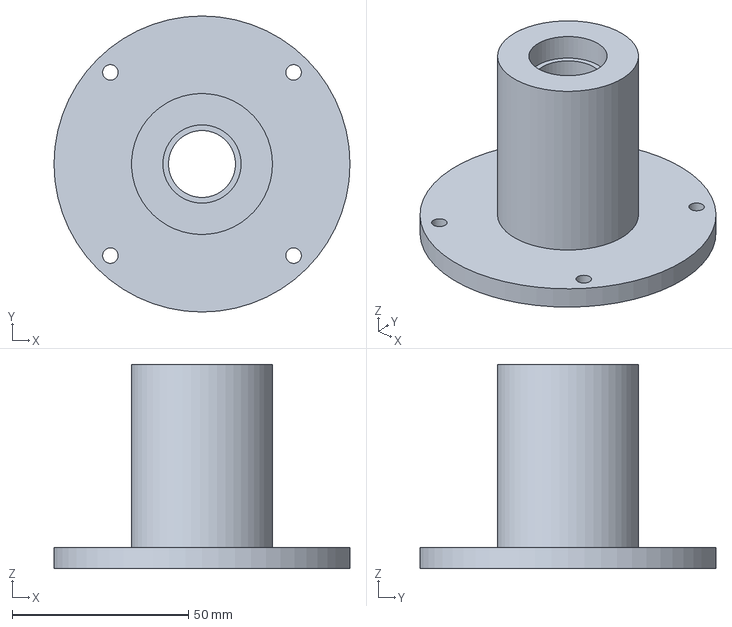
[picture p38: CAD file, 2026-10-25]
3D Print/Antenna_TheGioiIC_v3/STEP/02_azimuth_bearing_tower.step
84.0 x 84.0 x 58.0 mm
