TuanLinh05/antenna-fuzzy-control/3D Print/Antenna_V4_MT6701/STEP/11_servo_horn_shaft_coupler.step

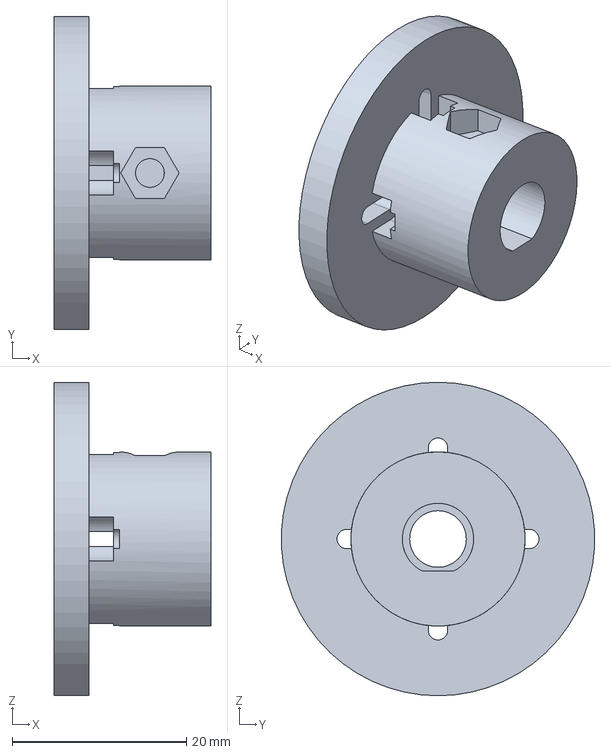
[picture p39: CAD file, 2026-10-25]
3D Print/Antenna_V4_MT6701/STEP/11_servo_horn_shaft_coupler.step
18.0 x 35.9 x 36.0 mm
