TuanLinh05/antenna-fuzzy-control/3D Print/Antenna_V4_MT6701/STEP/22_MT6701_fixed_bridge.step

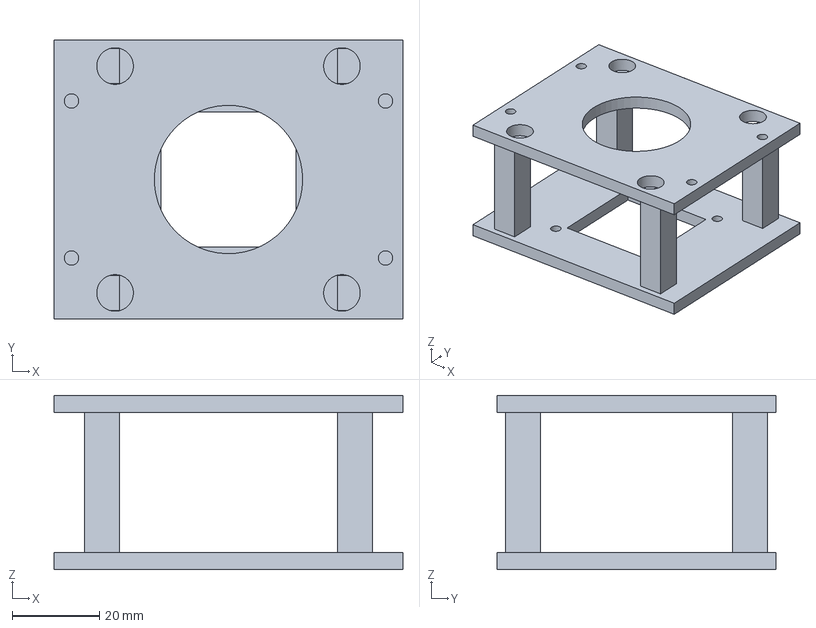
[picture p40: CAD file, 2026-10-25]
3D Print/Antenna_V4_MT6701/STEP/22_MT6701_fixed_bridge.step
80.0 x 64.0 x 40.0 mm
