TuanLinh05/antenna-fuzzy-control/3D Print/Antenna_TheGioiIC_v3/STEP/08_right_bearing_arm.step

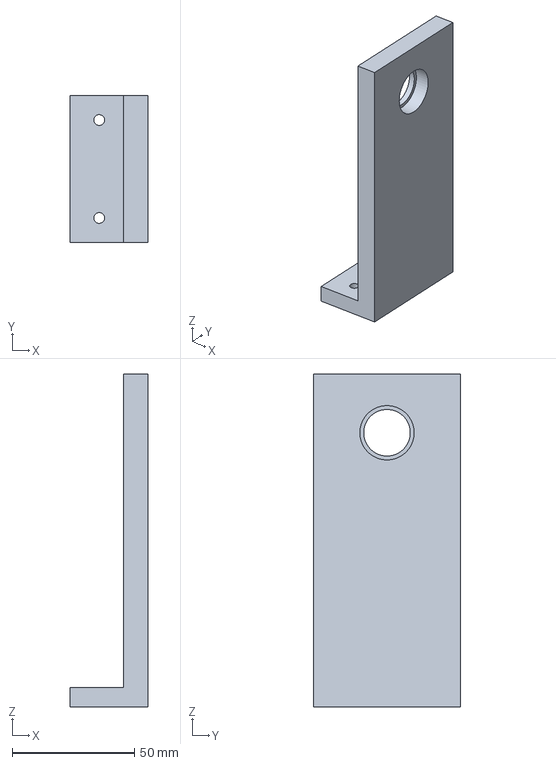
[picture p41: CAD file, 2026-10-25]
3D Print/Antenna_TheGioiIC_v3/STEP/08_right_bearing_arm.step
32.0 x 60.0 x 136.0 mm
