TuanLinh05/antenna-fuzzy-control/3D Print/Antenna_V4_MT6701/STEP/25_rotating_4x2_magnet_cap.step

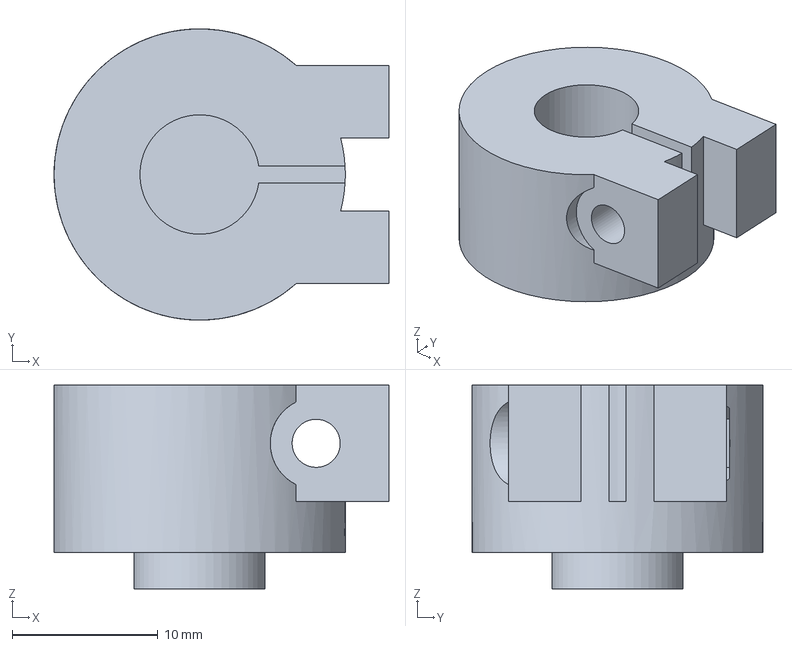
[picture p42: CAD file, 2026-10-25]
3D Print/Antenna_V4_MT6701/STEP/25_rotating_4x2_magnet_cap.step
23.0 x 20.0 x 14.0 mm
