TuanLinh05/antenna-fuzzy-control/3D Print/Antenna_V5_Reinforced/STEP/20_LD1501MG_mount_fit_gauge.step

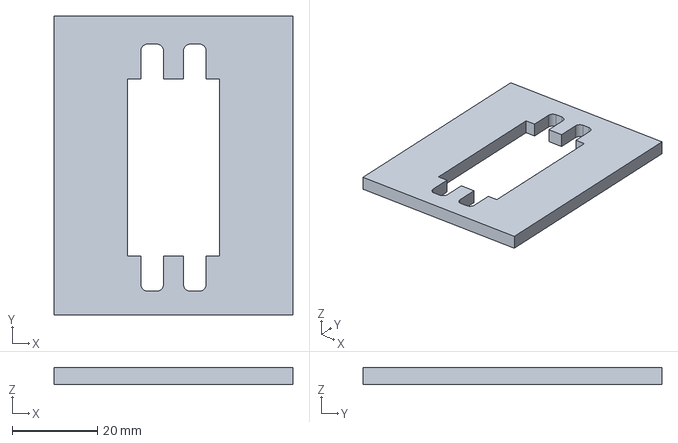
[picture p43: CAD file, 2026-10-25]
3D Print/Antenna_V5_Reinforced/STEP/20_LD1501MG_mount_fit_gauge.step
56.0 x 70.0 x 4.00 mm
