TuanLinh05/antenna-fuzzy-control/3D Print/Antenna_TheGioiIC_v3/STEP/12_parabolic_dish_160mm.step

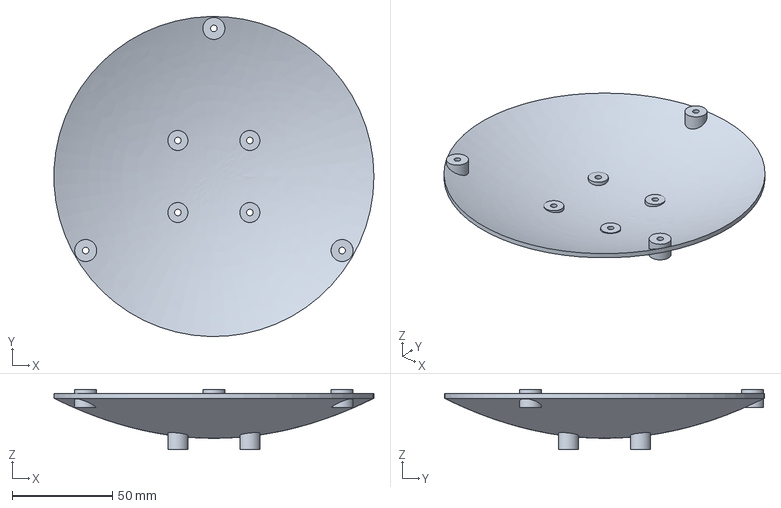
[picture p44: CAD file, 2026-10-25]
3D Print/Antenna_TheGioiIC_v3/STEP/12_parabolic_dish_160mm.step
159.9 x 159.9 x 30.0 mm
