TuanLinh05/antenna-fuzzy-control/3D Print/Antenna_V4_MT6701/STEP/16_608_fit_coupon.step

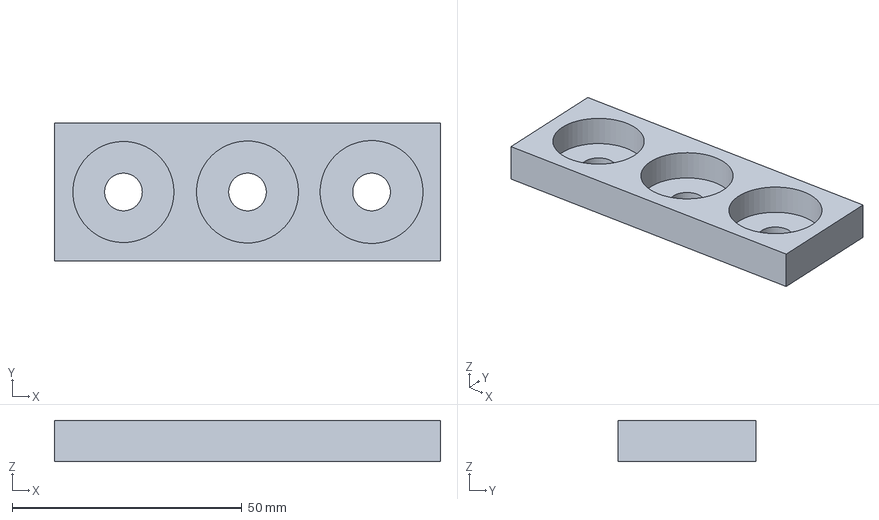
[picture p45: CAD file, 2026-10-25]
3D Print/Antenna_V4_MT6701/STEP/16_608_fit_coupon.step
84.0 x 30.0 x 9.00 mm
