TuanLinh05/antenna-fuzzy-control/3D Print/Antenna_V5_Reinforced/STEP/30_NEMA17_mount_fit_gauge.step

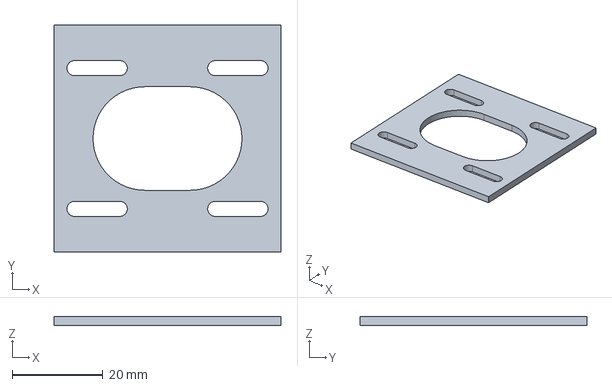
[picture p46: CAD file, 2026-10-25]
3D Print/Antenna_V5_Reinforced/STEP/30_NEMA17_mount_fit_gauge.step
50.0 x 50.0 x 2.00 mm
