TuanLinh05/antenna-fuzzy-control/3D Print/Antenna_TheGioiIC_v3/STEP/22_output_encoder_bracket.step

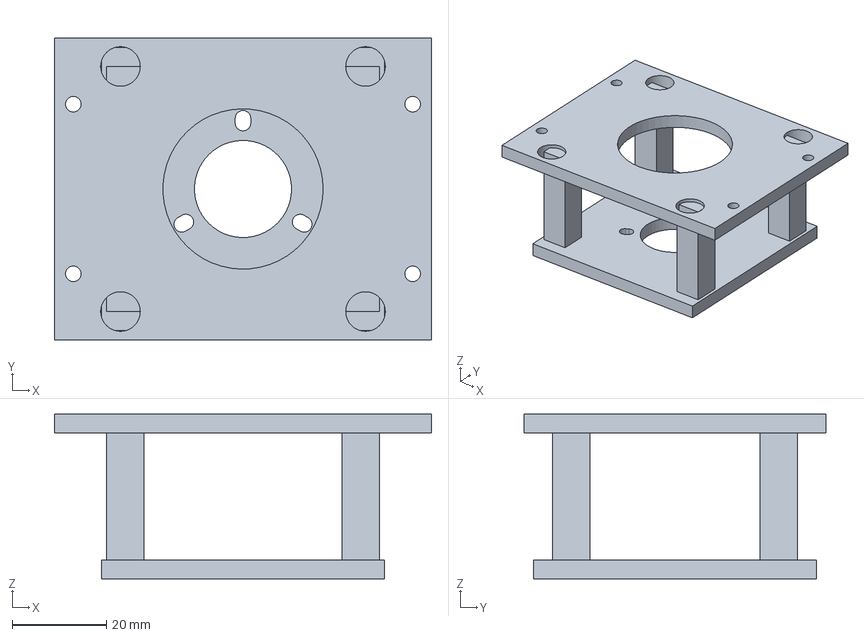
[picture p47: CAD file, 2026-10-25]
3D Print/Antenna_TheGioiIC_v3/STEP/22_output_encoder_bracket.step
80.0 x 64.0 x 35.0 mm
