TuanLinh05/antenna-fuzzy-control/3D Print/Antenna_TheGioiIC_v3/STEP/20_MG946R_mount_fit_gauge.step

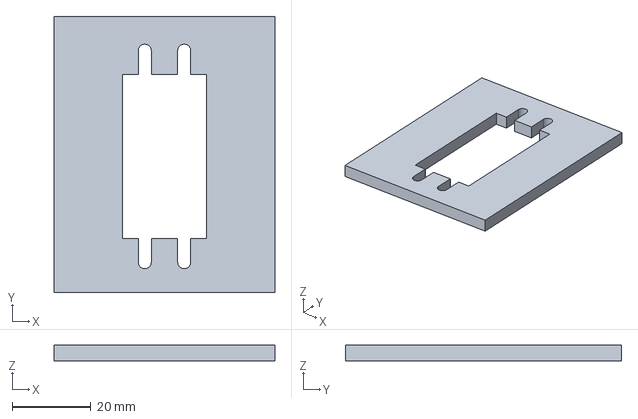
[picture p48: CAD file, 2026-10-25]
3D Print/Antenna_TheGioiIC_v3/STEP/20_MG946R_mount_fit_gauge.step
56.0 x 70.0 x 4.00 mm
