TuanLinh05/antenna-fuzzy-control/3D Print/Antenna_V5_Reinforced/STEP/28_motor_shaft_fit_gauge.step

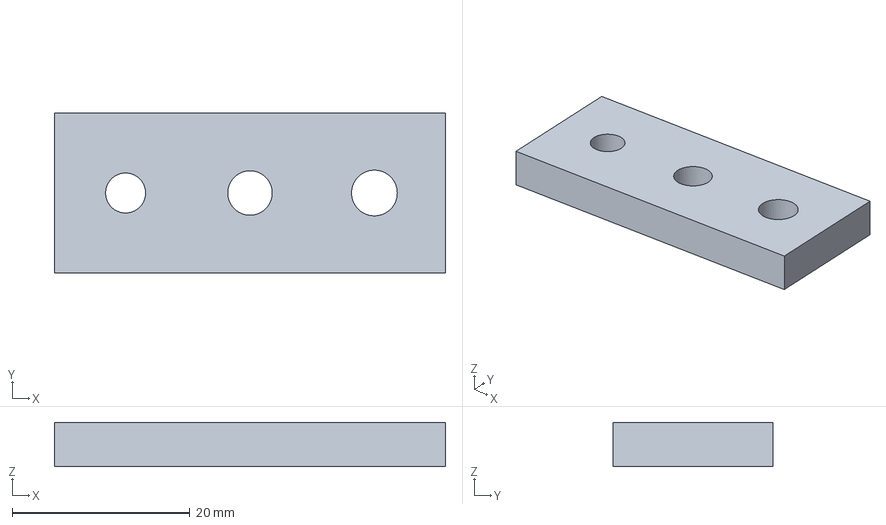
[picture p49: CAD file, 2026-10-25]
3D Print/Antenna_V5_Reinforced/STEP/28_motor_shaft_fit_gauge.step
44.0 x 18.0 x 5.00 mm
