TuanLinh05/antenna-fuzzy-control/3D Print/Antenna_V4_MT6701/STEP/27_4mm_magnet_fit_gauge.step

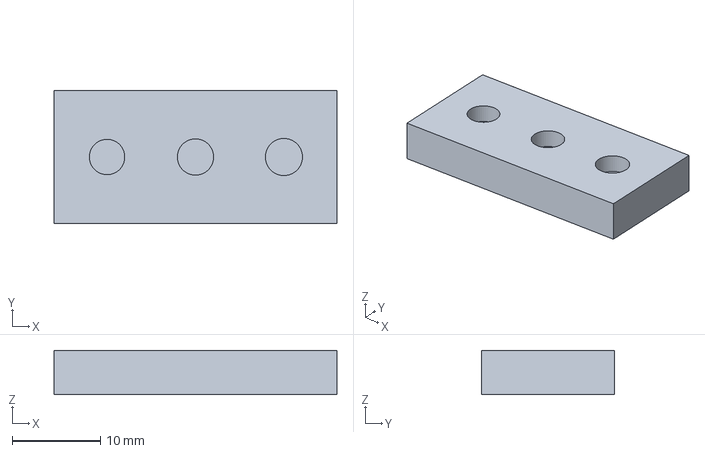
[picture p50: CAD file, 2026-10-25]
3D Print/Antenna_V4_MT6701/STEP/27_4mm_magnet_fit_gauge.step
32.0 x 15.0 x 5.00 mm
