TuanLinh05/antenna-fuzzy-control/(list of files, cad)

Other CAD files:
3D Print/Antenna_V5_Reinforced/3MF_plates/Plate_02_dish_cradle_feed_arms.3mf
3D Print/Antenna_V4_MT6701/3MF_plates/Plate_01_base_crossbeam.3mf
3D Print/Antenna_V5_Reinforced/3MF_plates/Plate_04_fit_test_and_feed_hub.3mf
3D Print/Antenna_TheGioiIC_v3/STEP/01_base.step
3D Print/Antenna_V5_Reinforced/3MF_A1_PETG_0p4/Plate_02_dish_cradle_feed_arms_A1_PETG_0p4.3mf
3D Print/Antenna_V5_Reinforced/3MF_plates/Plate_03_drive_and_servo_mounts.3mf
3D Print/Antenna_TheGioiIC_v3/3MF_plates/Plate_02_dish_cradle_feed_arms.3mf
3D Print/Antenna_TheGioiIC_v3/STEP/03_stepper_tension_bridge.step
3D Print/Antenna_V4_MT6701/3MF_plates/Plate_03_drive_and_servo_mounts.3mf
3D Print/Antenna_V5_Reinforced/3MF_plates/Plate_01_base_crossbeam.3mf
3D Print/Antenna_TheGioiIC_v3/STEP/09_left_bearing_arm.step
3D Print/Antenna_V5_Reinforced/3MF_A1_PETG_0p4/Plate_01_base_crossbeam_A1_PETG_0p4.3mf
3D Print/Antenna_V5_Reinforced/STEP/18_printed_split_shaft_collar.step
3D Print/Antenna_V5_Reinforced/STEP/01_base.step
3D Print/Antenna_V4_MT6701/STEP/17_shaft_fit_coupon.step
3D Print/Antenna_V5_Reinforced/STEP/03_stepper_tension_bridge.step
3D Print/Antenna_V4_MT6701/STEP/24_MT6701_XYZ_carrier.step
3D Print/Antenna_V4_MT6701/STEP/18_printed_split_shaft_collar.step
3D Print/Antenna_V5_Reinforced/STEP/02_azimuth_bearing_tower.step
3D Print/Antenna_TheGioiIC_v3/STEP/14_feed_strut.step
3D Print/Antenna_V5_Reinforced/STEP/29_servo_ear_0p5mm_spacer.step
3D Print/Antenna_TheGioiIC_v3/STEP/11_servo_horn_shaft_coupler.step
3D Print/Antenna_V5_Reinforced/STEP/13_dish_cradle.step
3D Print/Antenna_V4_MT6701/STEP/15_feed_hub.step
3D Print/Antenna_TheGioiIC_v3/STEP/23_D_shaft_fit_gauge.step
3D Print/Antenna_TheGioiIC_v3/STEP/13_dish_cradle.step
3D Print/Antenna_V4_MT6701/STEP/04_GT2_80T_integrated_rotor.step
3D Print/Antenna_TheGioiIC_v3/STEP/16_608_fit_coupon.step
3D Print/Antenna_V4_MT6701/STEP/30_NEMA17_mount_fit_gauge.step
3D Print/Antenna_V5_Reinforced/STEP/04_GT2_80T_integrated_rotor.step
3D Print/Antenna_TheGioiIC_v3/STEP/05_bearing_spacer.step
3D Print/Antenna_V4_MT6701/STEP/08_right_bearing_arm.step
3D Print/Antenna_V5_Reinforced/STEP/08_right_bearing_arm.step
3D Print/Antenna_V4_MT6701/STEP/23_D_shaft_fit_gauge.step
3D Print/Antenna_V5_Reinforced/STEP/26_MT6701_PCB_fit_gauge.step
3D Print/Antenna_V4_MT6701/STEP/20_LD1501MG_mount_fit_gauge.step
3D Print/Antenna_TheGioiIC_v3/STEP/17_shaft_fit_coupon.step
3D Print/Antenna_V4_MT6701/STEP/05_bearing_spacer.step
3D Print/Antenna_V5_Reinforced/STEP/14_feed_strut.step
3D Print/Antenna_V4_MT6701/STEP/28_motor_shaft_fit_gauge.step
3D Print/Antenna_V5_Reinforced/STEP/15_feed_hub.step
3D Print/Antenna_V5_Reinforced/STEP/25_rotating_4x2_magnet_cap.step
3D Print/Antenna_V5_Reinforced/STEP/12_parabolic_dish_160mm.step
3D Print/Antenna_V4_MT6701/STEP/07_fork_crossbeam.step
3D Print/Antenna_V5_Reinforced/STEP/07_fork_crossbeam.step
3D Print/Antenna_V4_MT6701/STEP/12_parabolic_dish_160mm.step
3D Print/Antenna_V5_Reinforced/STEP/27_4mm_magnet_fit_gauge.step
3D Print/Antenna_V5_Reinforced/STEP/16_608_fit_coupon.step
3D Print/Antenna_V5_Reinforced/STEP/09_left_bearing_arm.step
3D Print/Antenna_V4_MT6701/STEP/02_azimuth_bearing_tower.step
3D Print/Antenna_V5_Reinforced/STEP/11_servo_horn_shaft_coupler.step
3D Print/Antenna_TheGioiIC_v2/3MF_plates/12_parabolic_dish_160mm.3mf
3D Print/Antenna_TheGioiIC_v2/3MF_plates/Plate_01_base_crossbeam.3mf
3D Print/Antenna_TheGioiIC_v2/3MF_plates/Plate_02_dish_cradle_feed_arms.3mf
3D Print/Antenna_TheGioiIC_v2/3MF_plates/Plate_03_drive_and_servo_mounts.3mf
3D Print/Antenna_TheGioiIC_v2/3MF_plates/Plate_04_fit_test_and_feed_hub.3mf
3D Print/Antenna_TheGioiIC_v2/STEP/01_base.step
3D Print/Antenna_TheGioiIC_v2/STEP/02_azimuth_bearing_tower.step
3D Print/Antenna_TheGioiIC_v2/STEP/03_stepper_tension_bridge.step
3D Print/Antenna_TheGioiIC_v2/STEP/04_GT2_80T_integrated_rotor.step
3D Print/Antenna_TheGioiIC_v2/STEP/05_bearing_spacer.step
3D Print/Antenna_TheGioiIC_v2/STEP/07_fork_crossbeam.step
3D Print/Antenna_TheGioiIC_v2/STEP/08_right_bearing_arm.step
3D Print/Antenna_TheGioiIC_v2/STEP/09_left_bearing_arm.step
3D Print/Antenna_TheGioiIC_v2/STEP/10_MG946R_short_screw_carrier.step
3D Print/Antenna_TheGioiIC_v2/STEP/11_servo_horn_shaft_coupler.step
3D Print/Antenna_TheGioiIC_v2/STEP/12_parabolic_dish_160mm.step
3D Print/Antenna_TheGioiIC_v2/STEP/13_dish_cradle.step
3D Print/Antenna_TheGioiIC_v2/STEP/14_feed_strut.step
3D Print/Antenna_TheGioiIC_v2/STEP/15_feed_hub.step
3D Print/Antenna_TheGioiIC_v2/STEP/16_608_fit_coupon.step
3D Print/Antenna_TheGioiIC_v2/STEP/17_shaft_fit_coupon.step
3D Print/Antenna_TheGioiIC_v2/STEP/18_printed_split_shaft_collar.step
3D Print/Antenna_TheGioiIC_v2/STEP/19_bolted_printed_foot.step
3D Print/Antenna_TheGioiIC_v2/STEP/20_MG946R_mount_fit_gauge.step
3D Print/Antenna_TheGioiIC_v2/STEP/21_M3_motor_screw_washer_1mm.step
3D Print/Antenna_TheGioiIC_v2/STEP/ASSEMBLY_with_hardware_envelopes.step
3D Print/Antenna_TheGioiIC_v2/STL/01_base.stl
3D Print/Antenna_TheGioiIC_v2/STL/02_azimuth_bearing_tower.stl
3D Print/Antenna_TheGioiIC_v2/STL/03_stepper_tension_bridge.stl
3D Print/Antenna_TheGioiIC_v2/STL/04_GT2_80T_integrated_rotor.stl
3D Print/Antenna_TheGioiIC_v2/STL/05_bearing_spacer.stl
3D Print/Antenna_TheGioiIC_v2/STL/07_fork_crossbeam.stl
3D Print/Antenna_TheGioiIC_v2/STL/08_right_bearing_arm.stl
3D Print/Antenna_TheGioiIC_v2/STL/09_left_bearing_arm.stl
3D Print/Antenna_TheGioiIC_v2/STL/10_MG946R_short_screw_carrier.stl
3D Print/Antenna_TheGioiIC_v2/STL/11_servo_horn_shaft_coupler.stl
3D Print/Antenna_TheGioiIC_v2/STL/12_parabolic_dish_160mm.stl
3D Print/Antenna_TheGioiIC_v2/STL/13_dish_cradle.stl
3D Print/Antenna_TheGioiIC_v2/STL/14_feed_strut.stl
3D Print/Antenna_TheGioiIC_v2/STL/15_feed_hub.stl
3D Print/Antenna_TheGioiIC_v2/STL/16_608_fit_coupon.stl
3D Print/Antenna_TheGioiIC_v2/STL/17_shaft_fit_coupon.stl
3D Print/Antenna_TheGioiIC_v2/STL/18_printed_split_shaft_collar.stl
3D Print/Antenna_TheGioiIC_v2/STL/19_bolted_printed_foot.stl
3D Print/Antenna_TheGioiIC_v2/STL/20_MG946R_mount_fit_gauge.stl
3D Print/Antenna_TheGioiIC_v2/STL/21_M3_motor_screw_washer_1mm.stl
3D Print/Antenna_TheGioiIC_v3/STEP/10_MG946R_short_screw_carrier.step
3D Print/Antenna_TheGioiIC_v3/STEP/19_bolted_printed_foot.step
3D Print/Antenna_TheGioiIC_v3/STEP/21_M3_motor_screw_washer_1mm.step
3D Print/Antenna_TheGioiIC_v3/STL/01_base.stl
3D Print/Antenna_TheGioiIC_v3/STL/02_azimuth_bearing_tower.stl
3D Print/Antenna_TheGioiIC_v3/STL/03_stepper_tension_bridge.stl
3D Print/Antenna_TheGioiIC_v3/STL/04_GT2_80T_integrated_rotor.stl
3D Print/Antenna_TheGioiIC_v3/STL/05_bearing_spacer.stl
3D Print/Antenna_TheGioiIC_v3/STL/07_fork_crossbeam.stl
3D Print/Antenna_TheGioiIC_v3/STL/08_right_bearing_arm.stl
3D Print/Antenna_TheGioiIC_v3/STL/09_left_bearing_arm.stl
3D Print/Antenna_TheGioiIC_v3/STL/10_MG946R_short_screw_carrier.stl
3D Print/Antenna_TheGioiIC_v3/STL/11_servo_horn_shaft_coupler.stl
3D Print/Antenna_TheGioiIC_v3/STL/12_parabolic_dish_160mm.stl
3D Print/Antenna_TheGioiIC_v3/STL/13_dish_cradle.stl
3D Print/Antenna_TheGioiIC_v3/STL/14_feed_strut.stl
3D Print/Antenna_TheGioiIC_v3/STL/15_feed_hub.stl
3D Print/Antenna_TheGioiIC_v3/STL/16_608_fit_coupon.stl
3D Print/Antenna_TheGioiIC_v3/STL/17_shaft_fit_coupon.stl
3D Print/Antenna_TheGioiIC_v3/STL/18_printed_split_shaft_collar.stl
3D Print/Antenna_TheGioiIC_v3/STL/19_bolted_printed_foot.stl
3D Print/Antenna_TheGioiIC_v3/STL/20_MG946R_mount_fit_gauge.stl
3D Print/Antenna_TheGioiIC_v3/STL/21_M3_motor_screw_washer_1mm.stl
3D Print/Antenna_TheGioiIC_v3/STL/22_output_encoder_bracket.stl
3D Print/Antenna_TheGioiIC_v3/STL/23_D_shaft_fit_gauge.stl
3D Print/Antenna_TheGioiIC_v3/reference_previous/12_parabolic_dish_160mm_pre_V3.3mf
3D Print/Antenna_V4_MT6701/STEP/19_bolted_printed_foot.step
3D Print/Antenna_V4_MT6701/STEP/21_M3_motor_screw_washer_1mm.step
3D Print/Antenna_V4_MT6701/STL/01_base.stl
3D Print/Antenna_V4_MT6701/STL/02_azimuth_bearing_tower.stl
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
