TuanLinh05/antenna-fuzzy-control/3D Print/Antenna_TheGioiIC_v3/DANH_SACH_MUA_THEGIOIIC.md

# BOM V3 - kiểm tra ngày24/10/2026

Tất cả mã trong bảng dưới được kiểm tra trực tiếp trên trang sản phẩm tại Thế Giới IC. Tồn kho là ảnh chụp tại thời điểm kiểm tra, không phải giữ hàng. Motor IC5255 chỉ còn1 chiếc.

| Linh kiện | Mã/link | Cần | Đặt mua | Tồn | Giá/đơn vị | Thành tiền |
|---|---|---:|---:|---:|---:|---:|
| MG946R servo 180° + bộ tay đi kèm | [IC373](https://www.thegioiic.com/mg946r-dong-co-servo-giam-toc-rc-180-do-rang-kim-loai-12-kg-cm-4-8-7-2-v) | 1 | 1 | 60 | 98,220 | 98,220 |
| NEMA17 SL42STH40-1684A | [IC5255](https://www.thegioiic.com/sl42sth40-1684a-dong-co-buoc-nema17-42x42mm-1-8-0-4nm) | 1 | 1 | 1 | 210,900 | 210,900 |
| Pulley GT2 20T, lỗ 5 mm, rãnh 7 mm | [IC7387](https://www.thegioiic.com/gt2-banh-rang-puly-20-rang-buoc-2mm-ranh-day-dai-7mm-lo-5mm) | 1 | 1 | 46 | 11,400 | 11,400 |
| Dây vòng kín 2GT-280, rộng 6 mm | [IC20188](https://www.thegioiic.com/2gt-280-day-dai-140-rang-buoc-2-0-rong-6mm) | 1 | 1 | 46 | 17,100 | 17,100 |
| Vòng bi 608ZZ 8×22×7 mm | [IC15606](https://www.thegioiic.com/608zz-bac-dan-vong-bi-trong-8mm-ngoai-22mm-day-7mm) | 4 | 4 | 1599 | 3,420 | 13,680 |
| Thanh trượt inox 304 Ø8×200 mm | [IC17522](https://www.thegioiic.com/thanh-truot-8mm-dai-20cm-inox-304) | 1 | 1 | 49 | 19,753 | 19,753 |
| Vít M4×20 DIN912 304 | [IC10179](https://www.thegioiic.com/oc-luc-giac-m4-x-20mm-din912-304) | 20 | 24 | 3481 | 1,368 | 32,832 |
| Vít M3×8 DIN912 304 | [IC10152](https://www.thegioiic.com/oc-luc-giac-m3-x-8mm-din912-304) | 4 | 10 | 3975 | 650 | 6,500 |
| Vít M3×10 DIN912 304 | [IC10153](https://www.thegioiic.com/oc-luc-giac-m3-x-10mm-din912-304) | 6 | 10 | 16047 | 673 | 6,730 |
| Vít M3×12 DIN912 304 | [IC10154](https://www.thegioiic.com/oc-luc-giac-m3-x-12mm-din912-304) | 12 | 15 | 2150 | 713 | 10,695 |
| Vít M3×16 DIN912 304 | [IC10155](https://www.thegioiic.com/oc-luc-giac-m3-x-16mm-din912-304) | 6 | 10 | 9150 | 866 | 8,660 |
| Vít M3×20 DIN912 304 | [IC10156](https://www.thegioiic.com/oc-luc-giac-m3-x-20mm-din912-304) | 7 | 10 | 4553 | 1,083 | 10,830 |
| Vít M2×10 DIN912 304 | [IC10107](https://www.thegioiic.com/oc-luc-giac-m2-x-10mm-din912-304) | 2 | 20 | 2280 | 496 | 9,920 |
| Đai ốc thép M3 lục giác thường | [IC9122](https://www.thegioiic.com/dai-oc-thep-m3) | 28 | 30 | 12903 | 342 | 10,260 |
| Đai ốc thép M4 lục giác thường | [IC8318](https://www.thegioiic.com/dai-oc-thep-m4) | 20 | 30 | 363 | 388 | 11,640 |
| Đai ốc đồng M2 lục giác | [IC33241](https://www.thegioiic.com/dai-oc-dong-m2) | 2 | 10 | 265 | 570 | 5,700 |
| Encoder LPD3806-600BM NPN 600P/R | [IC3636](https://www.thegioiic.com/lpd3806-600bm-rotary-encoder-600-xung-npn-5-24vdc) | 1 | 1 | 123 | 318,060 | 318,060 |
| Khớp nối cứng D14 L25 lỗ6-8 | [IC20164](https://www.thegioiic.com/khop-noi-truc-cung-dai-25mm-lo-truc-6-8) | 1 | 1 | 24 | 11,400 | 11,400 |
| TB6600 driver stepper 42-57 4A | [IC7010](https://www.thegioiic.com/tb6600-mach-dieu-khien-dong-co-buoc-42-57-4a) | 1 | 1 | 275 | 116,046 | 116,046 |
| Adapter kín 12V5A DC5525 | [IC2723](https://www.thegioiic.com/nguon-adapter-12v-5a-dau-dc-5-5x2-5mm-dai-1m-co-led) | 1 | 1 | 142 | 83,220 | 83,220 |
| MP2482 module hạ áp 5V5A | [IC19734](https://www.thegioiic.com/mp2482-mach-on-ap-5v-5a) | 1 | 1 | 292 | 35,340 | 35,340 |
| 2N3904 NPN TO92 | [IC2033](https://www.thegioiic.com/2n3904-transistor-npn-40v-0-2a-3-chan-to-92) | 3 | 20 | 2260 | 342 | 6,840 |
| Điện trở1k 1/4W 5% | [IC921](https://www.thegioiic.com/dien-tro-1-kohm-1-4w-5-4-vong-mau) | 5 | 50 | 18500 | 55 | 2,750 |
| Điện trở4k7 1/4W 5% | [IC923](https://www.thegioiic.com/dien-tro-4-7-kohm-1-4w-5-4-vong-mau) | 3 | 50 | 20350 | 55 | 2,750 |
| Điện trở10k 1/4W 5% | [IC925](https://www.thegioiic.com/dien-tro-10-kohm-1-4w-5-4-vong-mau) | 3 | 50 | 10550 | 55 | 2,750 |
| Tụ hóa1000uF16V xuyên lỗ | [IC4475](https://www.thegioiic.com/tu-hoa-1000uf-16v-8x16mm-xuyen-lo) | 1 | 2 | 271 | 1,596 | 3,192 |
| Dây silicon18AWG đen | [IC37942](https://www.thegioiic.com/18awgx1-day-dien-silicon-chiu-nhiet-sieu-mem-mau-den-loai-tot) | 2 | 2 | 1706 | 15,960 | 31,920 |
| Dây silicon18AWG đỏ | [IC37941](https://www.thegioiic.com/18awgx1-day-dien-silicon-chiu-nhiet-sieu-mem-mau-do-loai-tot) | 2 | 2 | 372 | 15,960 | 31,920 |
| PCB hàn test FR4 5x7cm | [IC7157](https://www.thegioiic.com/fr4-pcb-han-test-board-5x7cm-phu-xanh-1-mat) | 1 | 1 | 1825 | 6,703 | 6,703 |
| Hàng rào đực2.54mm40chân đồng mạ niken | [IC22930](https://www.thegioiic.com/hang-rao-duc-don-2-54mm-40-chan-1-hang-cao-11-2mm-xuyen-lo-chan-dong-ma-niken) | 2 | 2 | 2839 | 1,596 | 3,192 |
| Dây bẹ cái-cái30cm | [IC2553](https://www.thegioiic.com/day-be-cai-cai-dai-30cm) | 10 | 20 | 16880 | 570 | 11,400 |
| Jack DC5525 cái kèm domino | [IC7741](https://www.thegioiic.com/dc5525-dau-noi-nguon-dc-cai-noi-day-kim-2-5mm-kem-domino) | 1 | 1 | 462 | 4,560 | 4,560 |
| Domino KF128-2-V5mm10A | [IC1167](https://www.thegioiic.com/kf128-2-v-domino-2-chan-thang-5mm-300v-10a-han-pcb-loai-tot) | 6 | 8 | 17832 | 2,850 | 22,800 |
| CP2102 USB-TTL UART | [IC3024](https://www.thegioiic.com/cp2102-mach-chuyen-doi-usb-to-ttl-uart) | 1 | 1 | 578 | 44,460 | 44,460 |
| Ống co nhiệt4mm600V | [IC2780](https://www.thegioiic.com/ong-co-nhiet-4mm-600v) | 1 | 1 | 2967 | 2,394 | 2,394 |

**Cơ khí: 814,280đ. Điện và vật tư: 412,237đ. Tổng mua mới: 1,226,517đ.**

Giá chưa gồm vận chuyển, nhựa in và dụng cụ. Có đủ20 vítM4x20DIN912 thì có thể bỏ dòngIC10179, giảm32.832đ.

Board STM32 bạn có sẵn không nằm trong tổng. Nếu cần mua: [IC4997](https://www.thegioiic.com/mach-stm32f103c8t6-micro-usb), 54,720đ, còn728 chiếc.

## Lưu ý chọn đúng linh kiện

- **IC373**: Thân 40×19×43 mm theo cửa hàng; dùng tay tròn và vít tâm trong bộ. Ảnh cửa hàng có các phụ kiện này; kiểm tra bộ nhận được.
- **IC5255**: Trục Ø5, nhô 20 mm, thân dài 40 mm, 1,68 A/pha; mẫu lỗ gá 31 mm theo NEMA17 danh định. Tồn chỉ 1.
- **IC7387**: Rãnh nhận đai 6 mm; căn giữa vùng răng tại Z=73 mm. Chiều dài dọc trục pulley chưa có bản vẽ đầy đủ.
- **IC20188**: 280 mm / 140 răng / bước 2 mm. Đúng cấu hình CAD V3.
- **IC15606**: 2 vòng bi phương vị và 2 vòng bi nâng; không đổi sang 688ZZ.
- **IC17522**: Cắt 120 +40 +30 mm; chừa tối đa 10 mm cho đường cắt và sửa đầu. Dũa mặt phẳng ở các vị trí truyền động theo hướng dẫn V3.
- **IC10179**: Khung 20 vị trí, dùng lại ốc đang có nếu đúng M4x20 DIN912. Không cần mua dòng này nếu đã đủ.
- **IC10152**: Adapter ép trục 1; mặt encoder 3 kèm đệm in 1 mm, vào ren encoder 3 mm danh định. Kiểm tra chiều sâu ren thực.
- **IC10153**: Motor 4 kèm đệm in 1 mm; giá chảo ép trục 2. Tối thiểu 10, bội 5.
- **IC10154**: Chân đế 4; tai servo 4; ép trục rotor 1; hub đầu thu 3. Tối thiểu 10, bội 5.
- **IC10155**: Vòng chặn 2; gá encoder vào đế 4.
- **IC10156**: Chảo vào giá 4; chân thanh đầu thu 3. Mua dư 3.
- **IC10107**: Ít nhất 2 lỗ đối xứng trên tay tròn servo. Tối thiểu 20, bội 10.
- **IC9122**: 28 đai ốc, gồm 4 dưới gá encoder. AF5.5 mm danh định.
- **IC8318**: AF danh định 7 mm; dày khoảng 3,2 mm. V3 dùng đai ốc thường, không cần loại mỏng. Tối thiểu 20, bội 10.
- **IC33241**: Dùng cho adapter tay servo; CAD giả định AF 4 mm, dày ≤2,8 mm, cần đo thực. Tối thiểu 10, bội 5.
- **IC3636**: Trục 6x13; thân D38; boss20x5; 3 lỗ M3 PCD28 hoặc30. Cấp5V; A/B kéo lên3.3V. Thân dài45mm là bao dự phòng, không phải kích thước nhà sản xuất.
- **IC20164**: Khớp đo encoder, không đỡ tải bàn xoay. Căn đồng tâm trước khi siết; vít hãm đi kèm cần kiểm tra khi nhận.
- **IC7010**: Cấp12V; chọn1/16 (3200 xung/vòng motor), bắt đầu mức dòng1.0A rồi thử tối đa1.5A theo bảng thực. Tín hiệu qua transistor, không nối3.3V trực tiếp vào opto5V.
- **IC2723**: Nguồn chính60W. Dùng jack cái5525 đúng2.5mm; đo cực tính trước khi đấu.
- **IC19734**: Vào7-30V, ra5V theo cửa hàng. Nhánh servo và encoder, có tụ1000uF. 5A là mức công bố; kiểm tra sụt áp và nhiệt dưới tải thực.
- **IC2033**: Ba kênh STEP, DIR, đệm servo. Tra đúng E/B/C theo datasheet ON Semiconductor; không suy ra từ hình vỏ.
- **IC921**: 3 điện trở base transistor; 2 nối tiếp A/B encoder.
- **IC923**: 2 kéo A/B lên3.3V; 1 kéo tín hiệu servo lên5V.
- **IC925**: Base-emitter kéo xuống cho3 transistor.
- **IC4475**: Lắp song song5V/GND sát đầu cấp servo, đúng cực. Mua1 dự phòng.
- **IC37942**: Đơn vị mét; dây GND nguồn, đi theo hình sao.
- **IC37941**: Đơn vị mét; nhánh12V/5V phân biệt và đánh dấu rõ.
- **IC7157**: Hàn mạch đệm và phân phối tín hiệu. Nhánh công suất dùng dây đồng18AWG, không dùng pad mảnh làm đường dòng servo.
- **IC22930**: Cắt header cho board và đầu servo. Hàn chắc các chân cấp nguồn.
- **IC2553**: Giá theo từng sợi; chỉ dùng cho tín hiệu và dòng nhỏ của MCU, không cấp dòng servo qua dây Dupont.
- **IC7741**: Khớp adapter5525; giữ lực kéo khỏi PCB, kiểm tra tiếp xúc và nhiệt khi chạy.
- **IC1167**: Nguồn vào, nguồn5V, encoder và các đầu dây. Mua2 dự phòng.
- **IC3024**: Nạp bằng bootloader UART hoặc ghi dữ liệu. TX/RX dùng mức3.3V; không cấp servo từ cổng này. Khi board đã cấp nguồn riêng chỉ nốiTX/RX/GND.
- **IC2780**: Đơn vị mét. Cách điện từng mối nối; dây servo cần nối dài bằng dây mềm và chừa vòng dây, không kéo căng dây300mm có sẵn.

Không thay bằng hàng hết kho hoặc loại cùng tên nhưng khác trục/điện áp. Các giá và tồn kho cũ ngày11/10 không còn là căn cứ mua.

Sản phẩmIC42490 bị loại vì thông số chênh áp mâu thuẫn; dây40cmIC43522 được thay bằng30cmIC2553. Không cần mua nguồnAC hở; adapter kín12V là nguồn điện lưới duy nhất.
