TuanLinh05/antenna-fuzzy-control/3D Print/Antenna_V5_Reinforced/PRINT_START_HERE.md

# In V5 bằng Bambu A1 0,4 mm / PETG

Mở các dự án trong **3MF_A1_PETG_0p4/** bằng Open Project. In **Plate_00_CALIBRATION_FIRST** trước để đo và thử lắp. Tổng cộng sáu dự án, 29 loại /43 vật in, không nhân đôi dưỡng.

Xem [thông số, support và cách chốt dung sai](print_profiles/README_A1_PETG.md). Bảng thời gian/nhựa ở [ESTIMATED_PRINTS.csv](print_profiles/ESTIMATED_PRINTS.csv).

Slicer dự báo tổng khoảng **132.53 giờ / 1369.23 g PETG**; đây là dự báo, chưa có in/đo thật. Các preset ưu tiên bề mặt và vách chịu lực, dùng nhựa PETG thường, Textured PEI. Nhiệt độ và flow vẫn cần khớp cuộn thực tế.
