TuanLinh05/antenna-fuzzy-control/3D Print/Antenna_V5_Reinforced/print_profiles/ESTIMATED_PRINTS.csv

project | object_count | estimated_hours | estimated_PETG_g | slicer_warning
Plate_00_CALIBRATION_FIRST_A1_PETG_0p4.3mf | 12 | 4.9 | 51.55
Plate_01_base_crossbeam_A1_PETG_0p4.3mf | 4 | 24.7 | 281.66
Plate_02_dish_cradle_feed_arms_A1_PETG_0p4.3mf | 5 | 29.14 | 198.63
Plate_03_drive_and_servo_mounts_A1_PETG_0p4.3mf | 7 | 52.28 | 606.95
Plate_04_fit_test_and_feed_hub_A1_PETG_0p4.3mf | 12 | 13.49 | 146.03
Plate_05_MT6701_and_fit_gauges_A1_PETG_0p4.3mf | 3 | 8.02 | 84.41
