TuanLinh05/antenna-fuzzy-control/3D Print/Antenna_TheGioiIC_v3/audit/initial_prototype_scenarios.csv

name | pass | expected_fault | overshoot_percent | tail_error_deg | peak_speed_deg_s | fault | fault_time_s
open_loop | 1 | 0 | 0 | 0.894718745014515 | 28.1138792325169 | 0 | NaN
load_torque | 0 | 0 | 0.429685633408915 | 0.01562500000775 | 46.4961054265827 | 0 | NaN
missed_pulses | 1 | 0 | 0.429685633408915 | 0.01562500000775 | 28.5411559991437 | 0 | NaN
high_inertia_and_backlash | 1 | 0 | 0.500698279937901 | 0.0851626218674892 | 29.9471815251448 | 0 | NaN
low_inertia | 1 | 0 | 0.402664474968956 | 0.0343750000093837 | 28.0561267085459 | 0 | NaN
encoder_noise | 1 | 0 | 0.423777911082023 | 0.0218749999961406 | 28.1138792325169 | 0 | NaN
slower_control_sample | 1 | 0 | 0.48179239434253 | 0.01562500000775 | 28.064186201992 | 0 | NaN
encoder_freeze | 1 | 1 | 0.41040651030537 | 63.9227940870388 | 28.1138792325169 | 4 | 13.42
communications_lost | 1 | 1 | 66.0726387865057 | 99.6435832719034 | 28.1138792325169 | 1 | 15
output_jam | 1 | 1 | 0.41040651030537 | 74.5562017221147 | 58.7527847513939 | 4 | 13.44
