TuanLinh05/antenna-fuzzy-control/3D Print/Antenna_TheGioiIC_v2/DANH_SACH_MUA_THEGIOIIC.md

# Danh sách mua cơ khí V2 — chỉ Thế Giới IC

Đối chiếu trực tiếp website ngày **11/10/2026**. Giá và tồn kho là số hiển thị khi tra cứu; cửa hàng có thể cập nhật trước khi đặt mua. Chưa đặt hàng.

Tổng theo lượng đề xuất mua: **484.820 đ**, có vít/đai ốc dư theo số lượng tối thiểu, chưa tính vận chuyển, nhựa in, dụng cụ và phần điện. CAD V2 được thiết kế theo đúng các mã chính bên dưới. Kích thước tai servo, tay tròn, chiều dọc trục pulley và dung sai trục/vòng bi vẫn cần lắp thử vì trang bán không cung cấp đủ bản vẽ chế tạo.

| Linh kiện | Mã | Cần | Nên mua | Giá/đv | Tồn khi tra | Ghi chú |
|---|---|---:|---:|---:|---:|---|
| [MG946R servo 180° + bộ tay đi kèm](https://www.thegioiic.com/mg946r-dong-co-servo-giam-toc-rc-180-do-rang-kim-loai-12-kg-cm-4-8-7-2-v) | IC373 | 1 | 1 | 98.220 đ | 61 | Thân 40×19×43 mm theo cửa hàng; dùng tay tròn và vít tâm trong bộ. Ảnh cửa hàng có các phụ kiện này; kiểm tra bộ nhận được. |
| [NEMA17 SL42STH40-1684A](https://www.thegioiic.com/sl42sth40-1684a-dong-co-buoc-nema17-42x42mm-1-8-0-4nm) | IC5255 | 1 | 1 | 210.900 đ | 1 | Trục Ø5, nhô 20 mm, thân dài 40 mm, 1,68 A/pha; mẫu lỗ gá 31 mm theo NEMA17 danh định. Tồn chỉ 1. |
| [Pulley GT2 20T, lỗ 5 mm, rãnh 7 mm](https://www.thegioiic.com/gt2-banh-rang-puly-20-rang-buoc-2mm-ranh-day-dai-7mm-lo-5mm) | IC7387 | 1 | 1 | 11.400 đ | 59 | Rãnh nhận đai 6 mm; căn giữa vùng răng tại Z=73 mm. Chiều dài dọc trục pulley chưa có bản vẽ đầy đủ. |
| [Dây vòng kín 2GT-280, rộng 6 mm](https://www.thegioiic.com/2gt-280-day-dai-140-rang-buoc-2-0-rong-6mm) | IC20188 | 1 | 1 | 17.100 đ | 50 | 280 mm / 140 răng / bước 2 mm. Đúng cấu hình CAD V2. |
| [Vòng bi 608ZZ 8×22×7 mm](https://www.thegioiic.com/608zz-bac-dan-vong-bi-trong-8mm-ngoai-22mm-day-7mm) | IC15606 | 4 | 4 | 3.420 đ | 1.625 | 2 vòng bi phương vị và 2 vòng bi nâng; không đổi sang 688ZZ. |
| [Thanh trượt inox 304 Ø8×200 mm](https://www.thegioiic.com/thanh-truot-8mm-dai-20cm-inox-304) | IC17522 | 1 | 1 | 19.753 đ | 55 | Tự cắt 110 + 40 + 30 mm; còn 20 mm cho đường cắt và sửa ba via. Phải thử độ trượt trong 608. |
| [Vít M4×20 DIN912 304](https://www.thegioiic.com/oc-luc-giac-m4-x-20mm-din912-304) | IC10179 | 20 | 24 | 1.368 đ | 3.529 | Trụ 4; gá stepper 4; dầm 4; càng 4; gá servo 4. Mua dư 4. |
| [Vít M3×8 DIN912 304](https://www.thegioiic.com/oc-luc-giac-m3-x-8mm-din912-304) | IC10152 | 1 | 10 | 650 đ | 4.250 | Ép trục ở adapter servo. Tối thiểu 10, bội 5. |
| [Vít M3×10 DIN912 304](https://www.thegioiic.com/oc-luc-giac-m3-x-10mm-din912-304) | IC10153 | 6 | 10 | 673 đ | 16.607 | Motor 4 kèm đệm in 1 mm; giá chảo ép trục 2. Tối thiểu 10, bội 5. |
| [Vít M3×12 DIN912 304](https://www.thegioiic.com/oc-luc-giac-m3-x-12mm-din912-304) | IC10154 | 12 | 15 | 713 đ | 2.700 | Chân đế 4; tai servo 4; ép trục rotor 1; hub đầu thu 3. Tối thiểu 10, bội 5. |
| [Vít M3×16 DIN912 304](https://www.thegioiic.com/oc-luc-giac-m3-x-16mm-din912-304) | IC10155 | 2 | 10 | 866 đ | 9.345 | Kẹp 2 vòng chặn in. Tối thiểu 10, bội 5. |
| [Vít M3×20 DIN912 304](https://www.thegioiic.com/oc-luc-giac-m3-x-20mm-din912-304) | IC10156 | 7 | 10 | 1.083 đ | 4.654 | Chảo vào giá 4; chân thanh đầu thu 3. Mua dư 3. |
| [Vít M2×10 DIN912 304](https://www.thegioiic.com/oc-luc-giac-m2-x-10mm-din912-304) | IC10107 | 2 | 20 | 496 đ | 2.610 | Ít nhất 2 lỗ đối xứng trên tay tròn servo. Tối thiểu 20, bội 10. |
| [Đai ốc thép M3 lục giác thường](https://www.thegioiic.com/dai-oc-thep-m3) | IC9122 | 24 | 30 | 342 đ | 14.943 | AF danh định 5,5 mm; dày khoảng 2,4 mm; không dùng loại mặt bích hoặc tán keo trong hốc. Tối thiểu 20, bội 10. |
| [Đai ốc thép M4 lục giác thường](https://www.thegioiic.com/dai-oc-thep-m4) | IC8318 | 20 | 30 | 388 đ | 1.013 | AF danh định 7 mm; dày khoảng 3,2 mm. V2 không cần đai ốc mỏng. Tối thiểu 20, bội 10. |
| [Đai ốc đồng M2 lục giác](https://www.thegioiic.com/dai-oc-dong-m2) | IC33241 | 2 | 10 | 570 đ | 550 | Dùng cho adapter tay servo; CAD giả định AF 4 mm, dày ≤2,8 mm, cần đo thực. Tối thiểu 10, bội 5. |

## Những món được thay bằng chi tiết in

- Pulley 80T và bàn xoay gộp thành **04**, bỏ 4 vít và 4 đai ốc mỏng ở V1.
- 2 vòng chặn trục dùng **18** và M3×16; không cần mua vòng chặn 8 mm.
- 4 chân đế dùng **19** và M3×12; không cần chân cao su dán.
- Đệm bắt motor 1 mm dùng **21**; kiểm tra độ sâu ren motor trước khi siết.
- Gá servo dùng **10**, bắt bằng M4×20 qua các hốc mở; không cần M4×55.
- Dùng tay tròn và vít giữ tâm **đi kèm MG946R** như ảnh sản phẩm. Adapter **11** bắt bằng M2 xuyên tay + đai ốc đồng. Không cần mua tay kim loại có spline chưa được xác nhận. Nếu bộ nhận được thiếu tay tròn/vít tâm, yêu cầu cửa hàng bổ sung đúng phụ kiện cùng mã servo trước khi lắp.

## Việc gia công nhỏ tại nhà

Cắt thanh trục 200 mm thành 110/40/30 mm, sửa sạch đầu cắt và tạo mặt phẳng nông cho vít ép. Nếu lỗ tay servo nhỏ hơn M2, mở hai lỗ đối xứng lên 2,2 mm; tâm lỗ cách trục trong khoảng **6,5–10,5 mm**. Không khoan hay sửa spline trung tâm. Chiều dày tay tròn trong CAD là 3 mm; thử adapter và chiều dài M2 trước khi in toàn bộ.

Các dụng cụ cắt, giũa, khoan nhỏ và khóa lục giác không nằm trong tổng trên; đây là thao tác tự gia công, không cần đặt gia công hoặc mua linh kiện ở cửa hàng khác. Không thể dùng cả thanh 200 mm mà không cắt trong bản lắp này.

## Lưu ý trước khi thanh toán

Motor IC5255 hiện chỉ còn **1 chiếc**. Nếu mã này hết hàng, cần chọn lại một motor tại Thế Giới IC có trục 5 mm, mẫu lỗ vuông 31 mm và thân không quá 48 mm rồi đối chiếu chiều dài trục; không tự đổi sang 17HD4401S vì trang của mã đó ghi trục 4,5 mm. Bản V2 đã dùng MG946R do [MG996R IC1858](https://www.thegioiic.com/mg996r-dong-co-servo-giam-toc-rc-180-do-rang-nhua-3-kg-cm-4-8-7-2-v) đang hết hàng.

Danh sách này bao gồm **phần cơ khí**. Driver giới hạn dòng cho stepper, nguồn servo và bộ điều khiển cần có để chạy; chưa có sơ đồ điện/firmware hay gá bo điện trong bộ CAD này. Có thể chọn phần điện tại cùng cửa hàng sau khi xác định bo điều khiển đang dùng.
