TuanLinh05/antenna-fuzzy-control/3D Print/Antenna_TheGioiIC_v3/preview/assembly_front.png

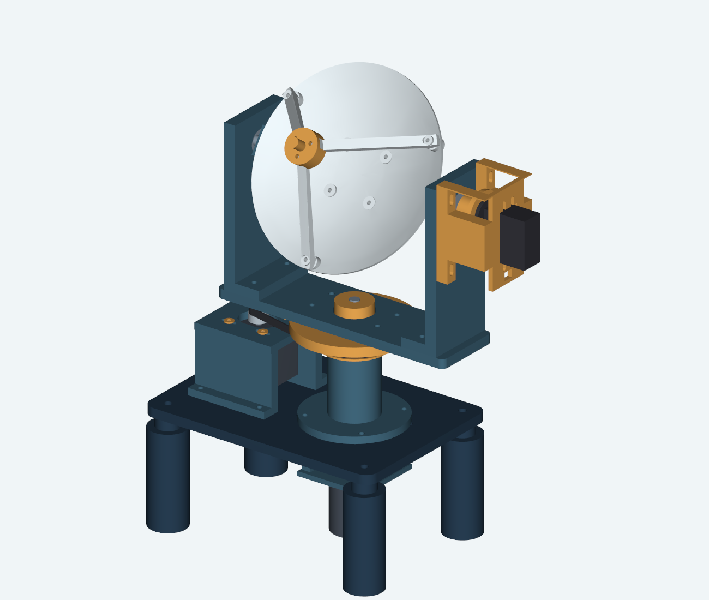
3D Print/Antenna_TheGioiIC_v3/preview/assembly_front.png
