TuanLinh05/antenna-fuzzy-control/3D Print/Antenna_TheGioiIC_v3/preview/elevation_0.png

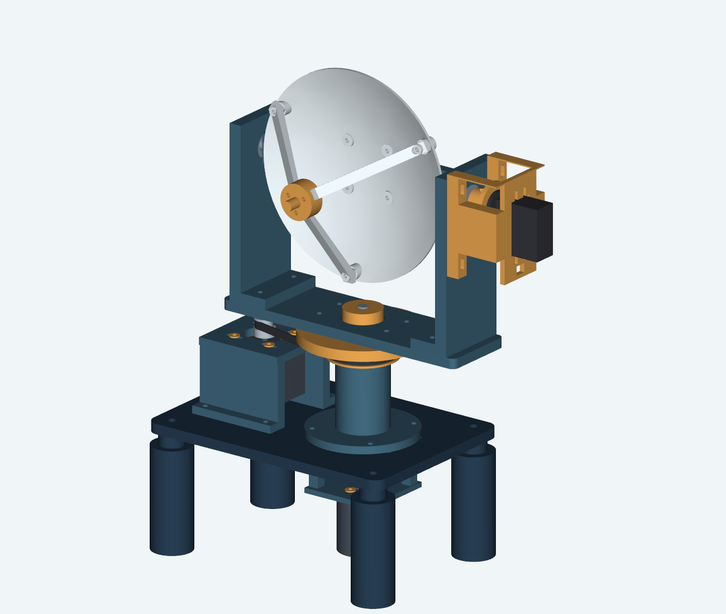
3D Print/Antenna_TheGioiIC_v3/preview/elevation_0.png
