TuanLinh05/antenna-fuzzy-control/3D Print/Antenna_V4_MT6701/preview/GT2_transmission_dimensions.png

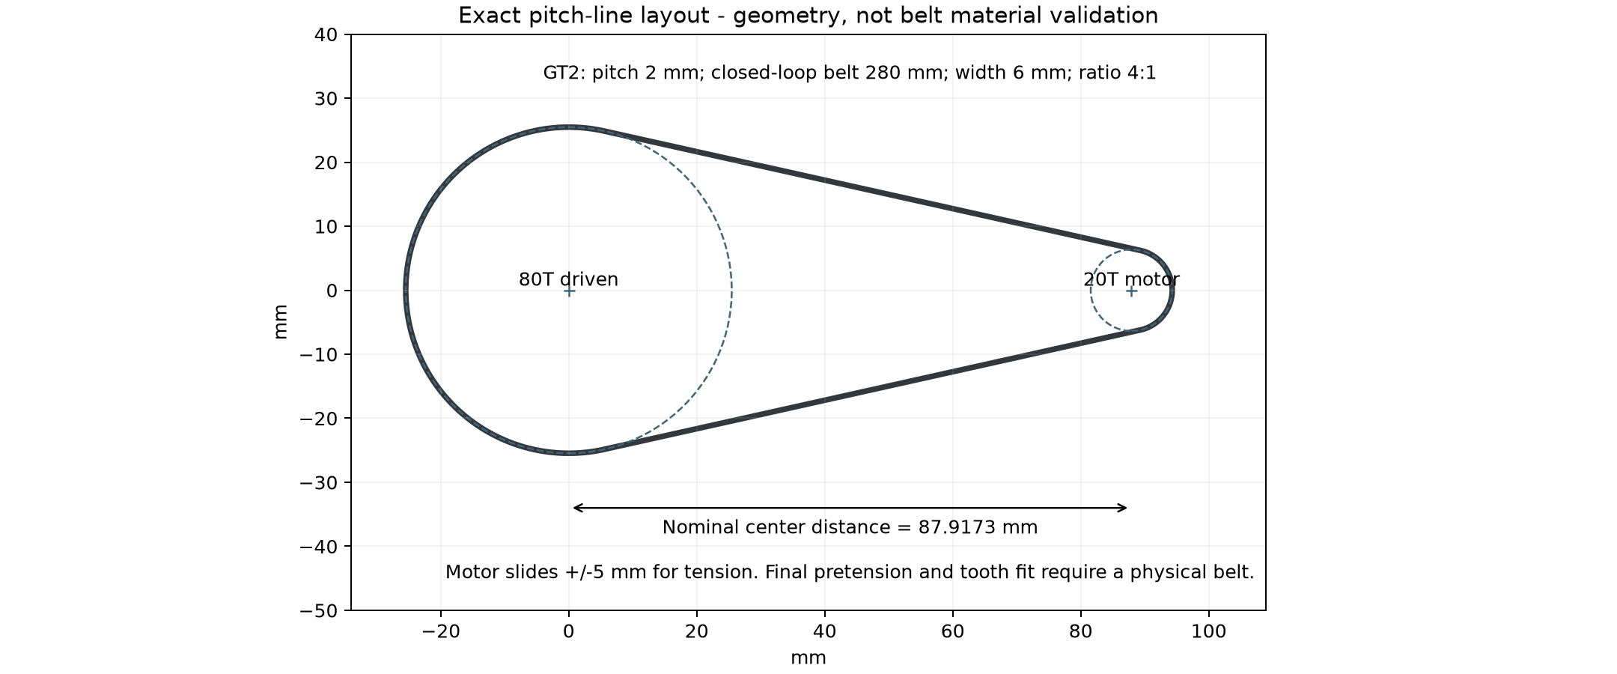
3D Print/Antenna_V4_MT6701/preview/GT2_transmission_dimensions.png
