TuanLinh05/antenna-fuzzy-control/3D Print/Antenna_V4_MT6701/preview/MT6701_underside.png

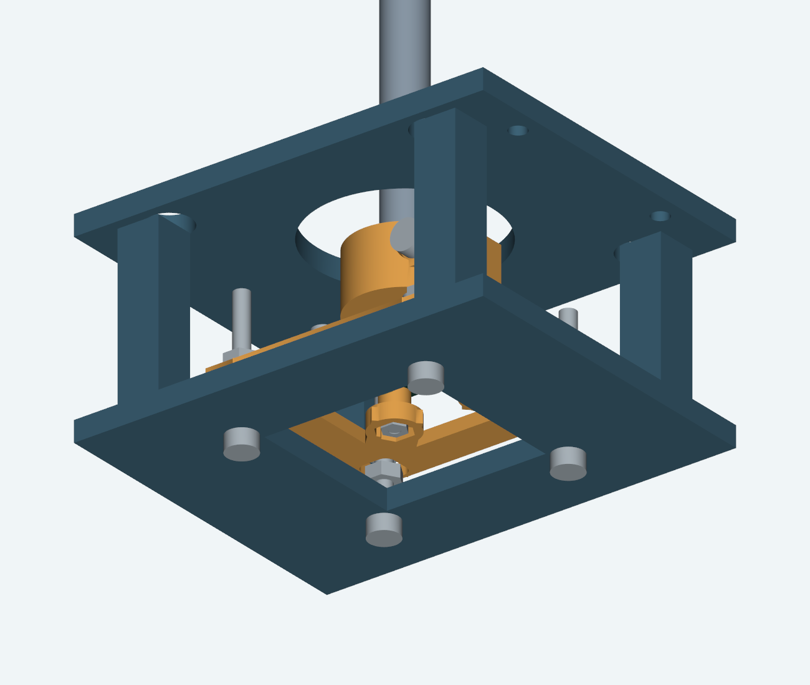
3D Print/Antenna_V4_MT6701/preview/MT6701_underside.png
