TuanLinh05/antenna-fuzzy-control/3D Print/Antenna_V5_Reinforced/preview/assembly_rear.png

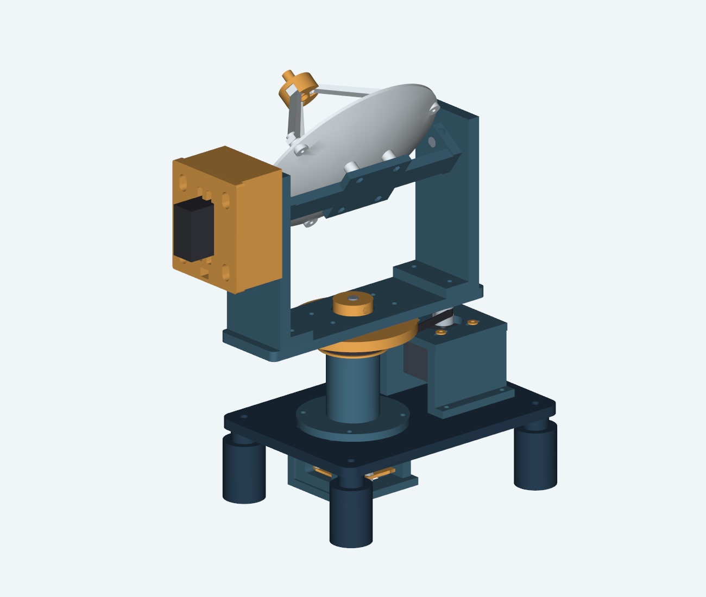
3D Print/Antenna_V5_Reinforced/preview/assembly_rear.png
