TuanLinh05/antenna-fuzzy-control/3D Print/Antenna_V5_Reinforced/preview/MT6701_open_front.png

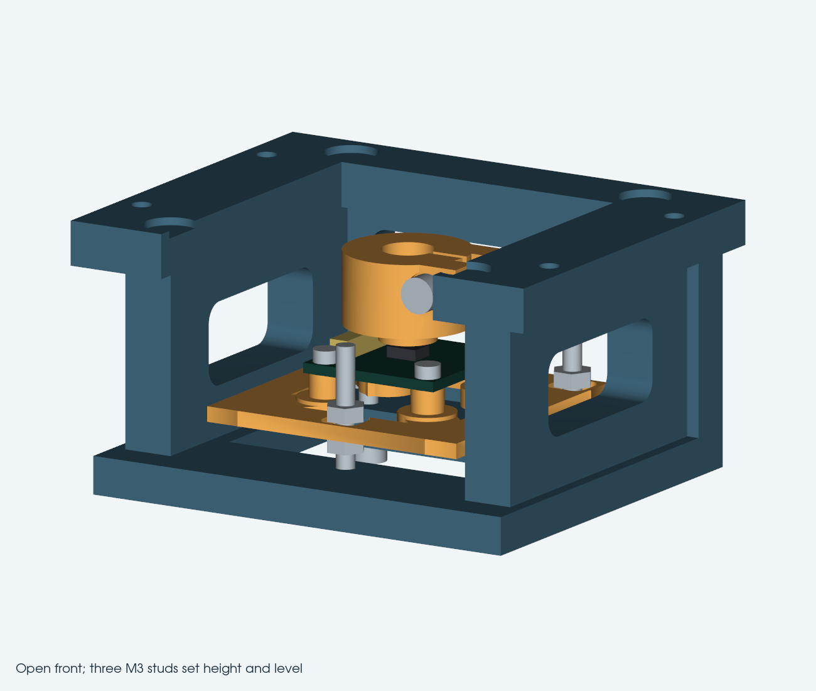
3D Print/Antenna_V5_Reinforced/preview/MT6701_open_front.png
