TuanLinh05/antenna-fuzzy-control/3D Print/Antenna_V5_Reinforced/preview/Plate_01_base_crossbeam_A1_PETG_0p4_support.png

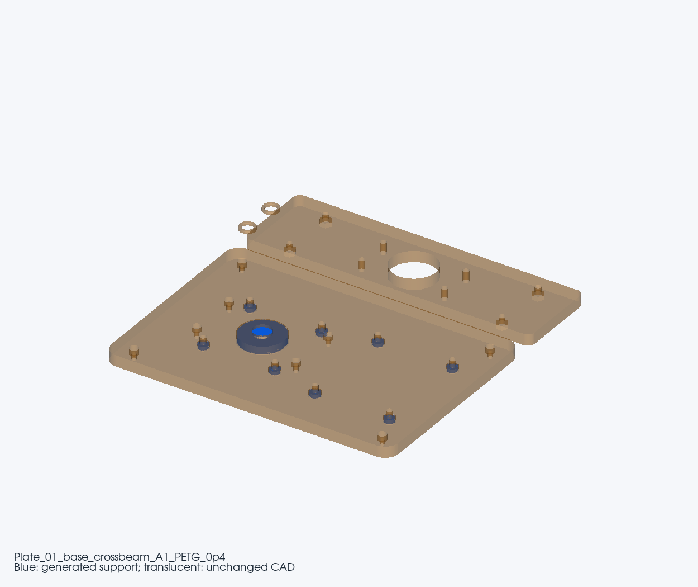
3D Print/Antenna_V5_Reinforced/preview/Plate_01_base_crossbeam_A1_PETG_0p4_support.png
