TuanLinh05/antenna-fuzzy-control/3D Print/Antenna_V5_Reinforced/preview/Plate_03_drive_and_servo_mounts_A1_PETG_0p4_support.png

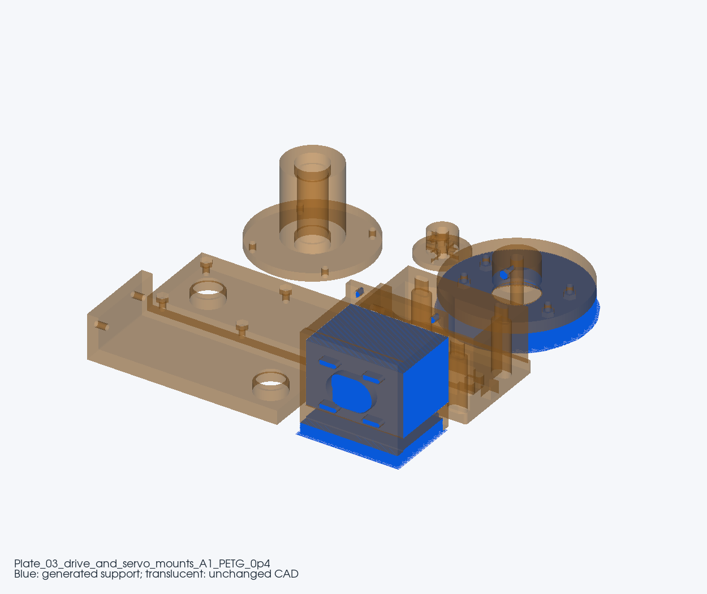
3D Print/Antenna_V5_Reinforced/preview/Plate_03_drive_and_servo_mounts_A1_PETG_0p4_support.png
