TuanLinh05/antenna-fuzzy-control/3D Print/Antenna_V5_Reinforced/preview/Plate_05_MT6701_and_fit_gauges_A1_PETG_0p4_support.png

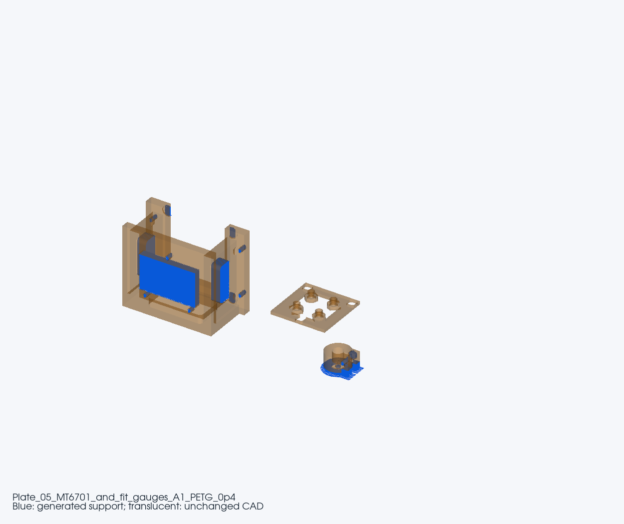
3D Print/Antenna_V5_Reinforced/preview/Plate_05_MT6701_and_fit_gauges_A1_PETG_0p4_support.png
