TuanLinh05/antenna-fuzzy-control/3D Print/Antenna_V5_Reinforced/preview/servo_before_V4.png

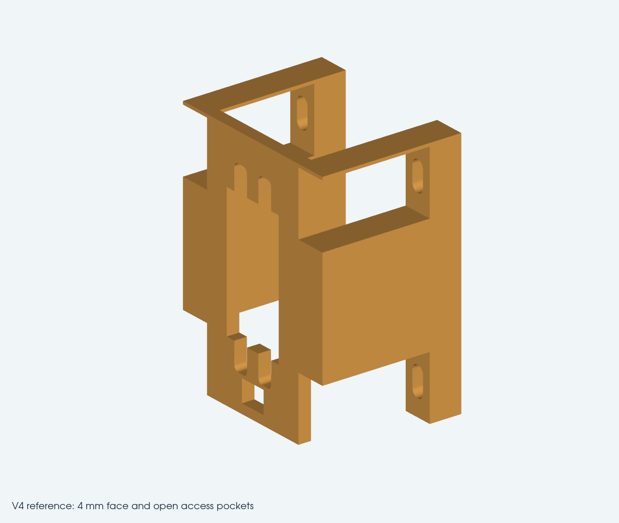
3D Print/Antenna_V5_Reinforced/preview/servo_before_V4.png
