TuanLinh05/antenna-fuzzy-control/3D Print/Antenna_V5_Reinforced/preview/servo_reinforced_inside_V5.png

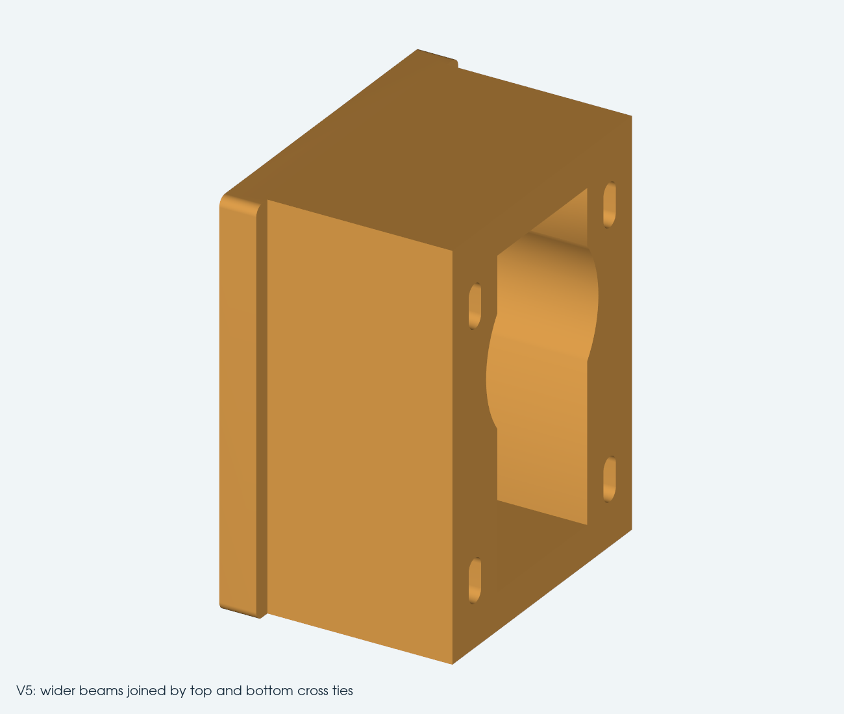
3D Print/Antenna_V5_Reinforced/preview/servo_reinforced_inside_V5.png
