TuanLinh05/antenna-fuzzy-control/Simulation/results/dc_tuning.csv

candidate | error_width_rad | accel_rad_s2 | kp_velocity | settling_sum_s | overshoot_percent | tail_error_rad | peak_speed_rad_s | pass
1 | 0.08 | 0.8 | 6 | 13.28 | 0.117006169751626 | 4.22517417764112e-06 | 0.489368076775579 | 1
2 | 0.08 | 0.8 | 12 | 13.2829 | 0.103199919704107 | 3.81623787371055e-06 | 0.489074562469493 | 1
3 | 0.08 | 1.2 | 6 | 12.677 | 0.139446260377302 | 4.79169568479154e-06 | 0.493528354771293 | 1
4 | 0.08 | 1.2 | 12 | 12.68 | 0.118339911923522 | 4.24854639025085e-06 | 0.493190403149338 | 1
5 | 0.08 | 1.8 | 6 | 12.3951 | 0 | 2.76113318220528e-06 | 0.498160547990938 | 1
6 | 0.08 | 1.8 | 12 | 12.3975 | 0 | 2.72226723574409e-06 | 0.497643940236885 | 1
7 | 0.12 | 0.8 | 6 | 13.2801 | 0.116997860915189 | 6.24968266804693e-06 | 0.489362711337171 | 1
8 | 0.12 | 0.8 | 12 | 13.2829 | 0.103188714397546 | 5.70036166724908e-06 | 0.489072098100718 | 1
9 | 0.12 | 1.2 | 6 | 12.9153 | 0 | 2.78157168032145e-06 | 0.493263369017953 | 1
10 | 0.12 | 1.2 | 12 | 12.9205 | 0 | 2.98605717974354e-06 | 0.493008935136673 | 1
11 | 0.12 | 1.8 | 6 | 12.6907 | 0 | 2.72849648252915e-06 | 0.498044085655793 | 1
12 | 0.12 | 1.8 | 12 | 12.6926 | 0 | 2.93768641645986e-06 | 0.497562061927994 | 1
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
