TuanLinh05/antenna-fuzzy-control/Simulation/results/dc_uncertainty.csv

case_id | pass | overshoot_percent | tail_error_rad | peak_speed_rad_s | settling_sum_s
1 | 1 | 0.00519798664524757 | 2.97945376458442e-05 | 0.479980194177799 | 12.5078
2 | 1 | 0 | 1.79906467733248e-05 | 0.515298763303444 | 12.3161
3 | 1 | 0.000722351401935107 | 4.76506904012464e-06 | 0.507591947418776 | 12.389
4 | 1 | 0 | 2.03400985585578e-05 | 0.504989415594882 | 12.3589
5 | 1 | 0 | 1.43735719637661e-06 | 0.502825091333855 | 12.3322
6 | 1 | 0 | 1.88674147454382e-05 | 0.51027551186693 | 12.3211
7 | 1 | 0 | 1.06226106381113e-05 | 0.507040051296129 | 12.2935
8 | 1 | 0.0125001373658235 | 4.78183376579899e-05 | 0.479963967486069 | 12.5576
9 | 1 | 0 | 4.3993594914804e-06 | 0.509276491781348 | 12.2769
10 | 1 | 0.00820145668200278 | 4.06338361431668e-05 | 0.486584925945433 | 12.5253
11 | 1 | 0.00284301414065185 | 1.89395812065785e-05 | 0.504402175445456 | 12.3757
12 | 1 | 0 | 9.00818525462199e-06 | 0.515472303412764 | 12.2661
