TuanLinh05/antenna-fuzzy-control/Simulation/results/prototype_scenarios.csv

name | pass | expected_fault | stress_observation | tracking_requirements_met | overshoot_percent | tail_error_deg | peak_speed_deg_s | fault | fault_time_s
open_loop | 1 | 0 | 0 | 0 | 0 | 0.896500072666913 | 27.7167033029167 | 0 | NaN
load_torque | 1 | 0 | 0 | 1 | 0.379254149967126 | 0.0124999999922768 | 27.7192764385411 | 0 | NaN
missed_pulses | 1 | 0 | 0 | 1 | 0.393847836995852 | 0.0124999999922768 | 27.9884549981172 | 0 | NaN
high_inertia_and_backlash | 1 | 0 | 0 | 1 | 0.532377449115031 | 0.086449083937706 | 29.4575739777175 | 0 | NaN
low_inertia | 1 | 0 | 0 | 1 | 0.376409906245387 | 0.0343750000093582 | 27.4589454552714 | 0 | NaN
encoder_noise | 1 | 0 | 0 | 1 | 0.436466680337433 | 0.0218749999922858 | 27.7232640720391 | 0 | NaN
slower_control_sample | 1 | 0 | 0 | 1 | 0.462548513865384 | 0.0156250000077246 | 27.7015338964319 | 0 | NaN
encoder_freeze | 1 | 1 | 0 | 0 | 0.379254149967126 | 63.9231180875781 | 27.7192281667454 | 4 | 13.43
communications_lost | 1 | 1 | 0 | 0 | 64.2413705246431 | 98.5448223147859 | 27.7192281667454 | 1 | 15
output_jam | 1 | 1 | 0 | 0 | 0.379254149967126 | 74.314481704627 | 48.2774923285951 | 4 | 13.44
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
