TuanLinh05/antenna-fuzzy-control/Simulation_V5/results/tune_stage1.csv

v_max_dps | accel_dps2 | smooth_n | sum_ts2_s | worst_ts2_s | worst_pot_pct | peak_speed_dps | final_meas_deg | feasible | feasible_robust | robust_peak_dps | robust_pot_pct
20 | 60 | 1 | 17.4840016102297 | 6.21700053667928 | 0.00452757640705331 | 24.3880859234879 | 0.0728033961745133 | 0 | 0 | NaN | NaN
22 | 60 | 1 | 16.0100016102293 | 5.68200053667863 | 0.020539219899556 | 24.9949038874955 | 0.0499517688721871 | 1 | 1 | 26.9085570140889 | 0.00107847295722572
24 | 60 | 1 | 14.8010016102289 | 5.23900053667808 | 0.0439177208323064 | 28.4963901955813 | 0.0463661927654975 | 1 | 1 | 28.5745319986994 | 0.00101701110543968
26 | 60 | 1 | 13.7670016102291 | 4.86500053667763 | 0.0449505334342549 | 29.3346573594646 | 0.0468057837404754 | 1 | 1 | 32.1441782113456 | 0.00085064942212335
28 | 60 | 1 | 12.8890016102292 | 4.54700053667724 | 0.0489518944767413 | 30.7547241516798 | 0.0476848290866637 | 0 | 0 | NaN | NaN
20 | 90 | 1 | 17.2540016102297 | 6.16200053667921 | 0.0197575511249924 | 25.6040085413923 | 0.0490731333373589 | 1 | 1 | 26.1090366212202 | 0.000975614611343794
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
