TuanLinh05/antenna-fuzzy-control/Review_2026-10-24/results/legacy_true_vs_encoder.csv

target_deg | true_model_tail_error_deg | encoder_tail_error_deg
60 | 0.00625000000771081 | 7.105427357601e-15
150 | 0.00625000001545573 | 2.8421709430404e-14
30 | 0.00625000000385612 | 3.5527136788005e-15
90 | 0.0124999999922863 | 1.4210854715202e-14
