TuanLinh05/antenna-fuzzy-control/3D Print/Antenna_V5_Reinforced/preview/Plate_00_CALIBRATION_FIRST_A1_PETG_0p4_support.png

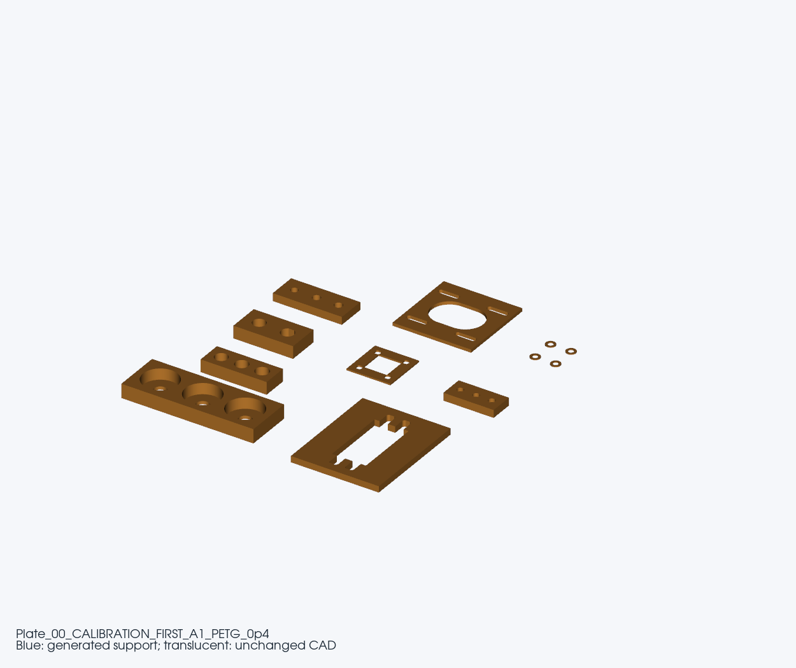
3D Print/Antenna_V5_Reinforced/preview/Plate_00_CALIBRATION_FIRST_A1_PETG_0p4_support.png
