TuanLinh05/antenna-fuzzy-control/3D Print/Antenna_V5_Reinforced/preview/Plate_04_fit_test_and_feed_hub_A1_PETG_0p4_support.png

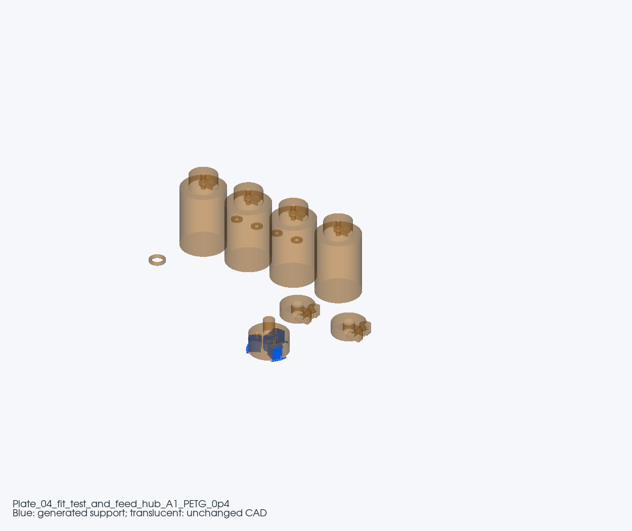
3D Print/Antenna_V5_Reinforced/preview/Plate_04_fit_test_and_feed_hub_A1_PETG_0p4_support.png
