TuanLinh05/antenna-fuzzy-control/Simulation/results/animation_first_frame.png

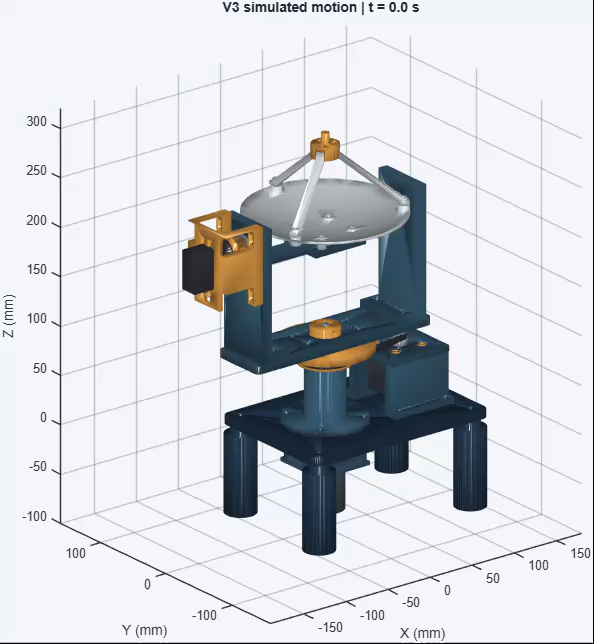
Simulation/results/animation_first_frame.png
