TuanLinh05/antenna-fuzzy-control/Simulation/results/animation_last_frame.png

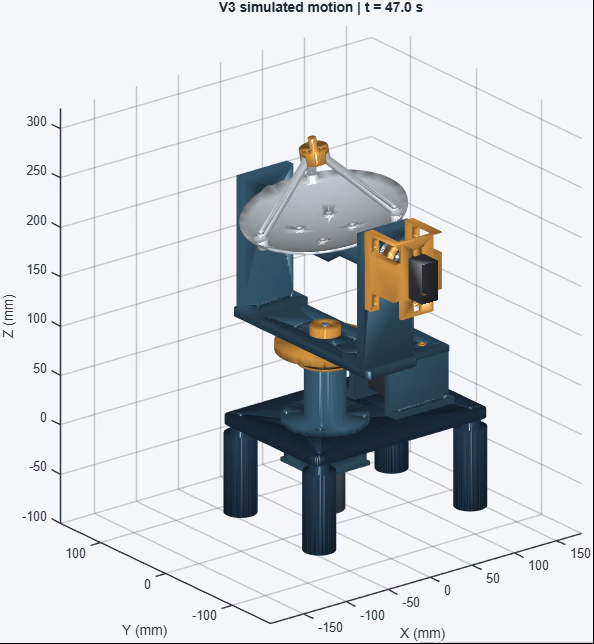
Simulation/results/animation_last_frame.png
