TuanLinh05/antenna-fuzzy-control/Simulation/results/antenna_CAD_in_MATLAB.png

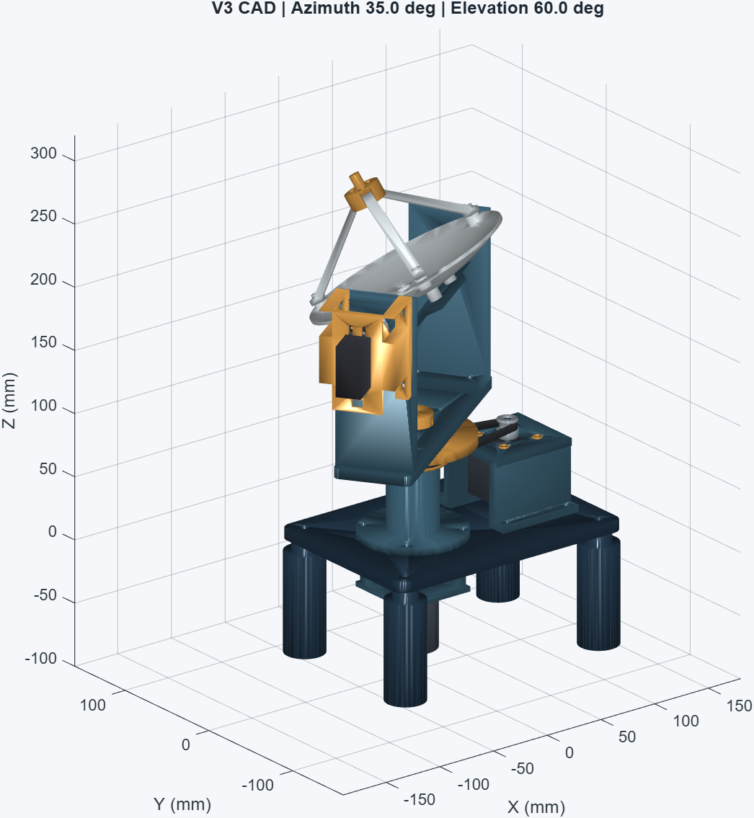
Simulation/results/antenna_CAD_in_MATLAB.png
