TuanLinh05/antenna-fuzzy-control/Simulation/results/dc_assignment.png

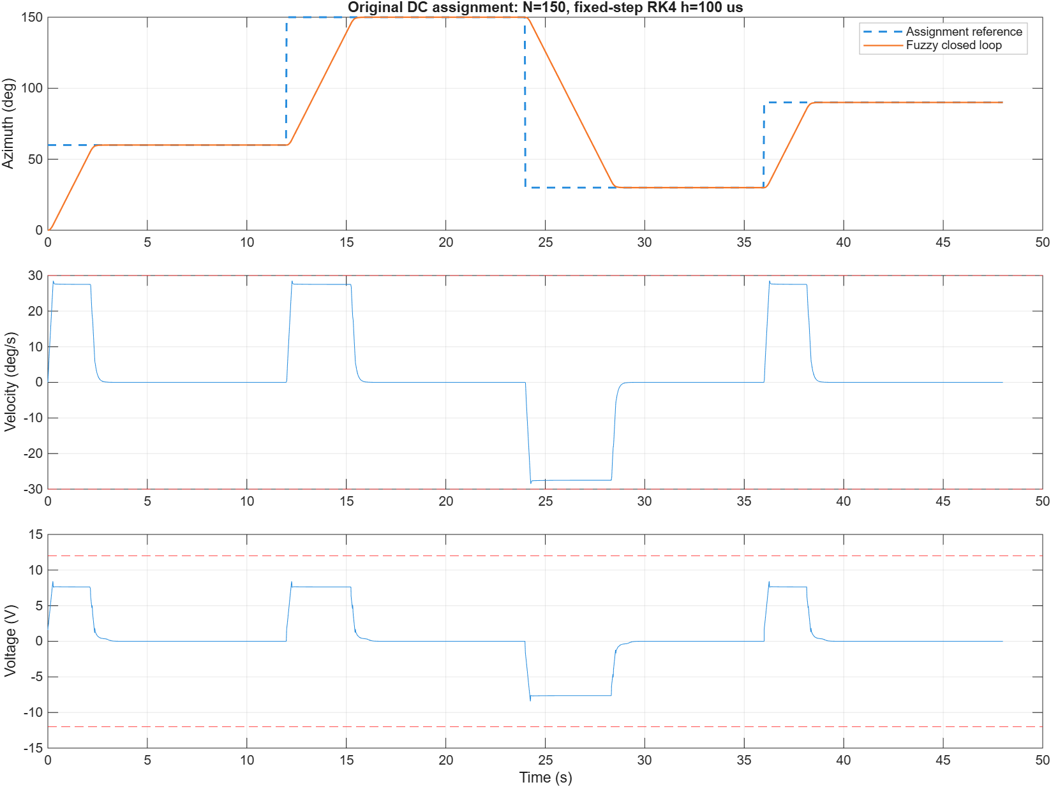
Simulation/results/dc_assignment.png
