TuanLinh05/antenna-fuzzy-control/Simulation/results/prototype_tracking.png

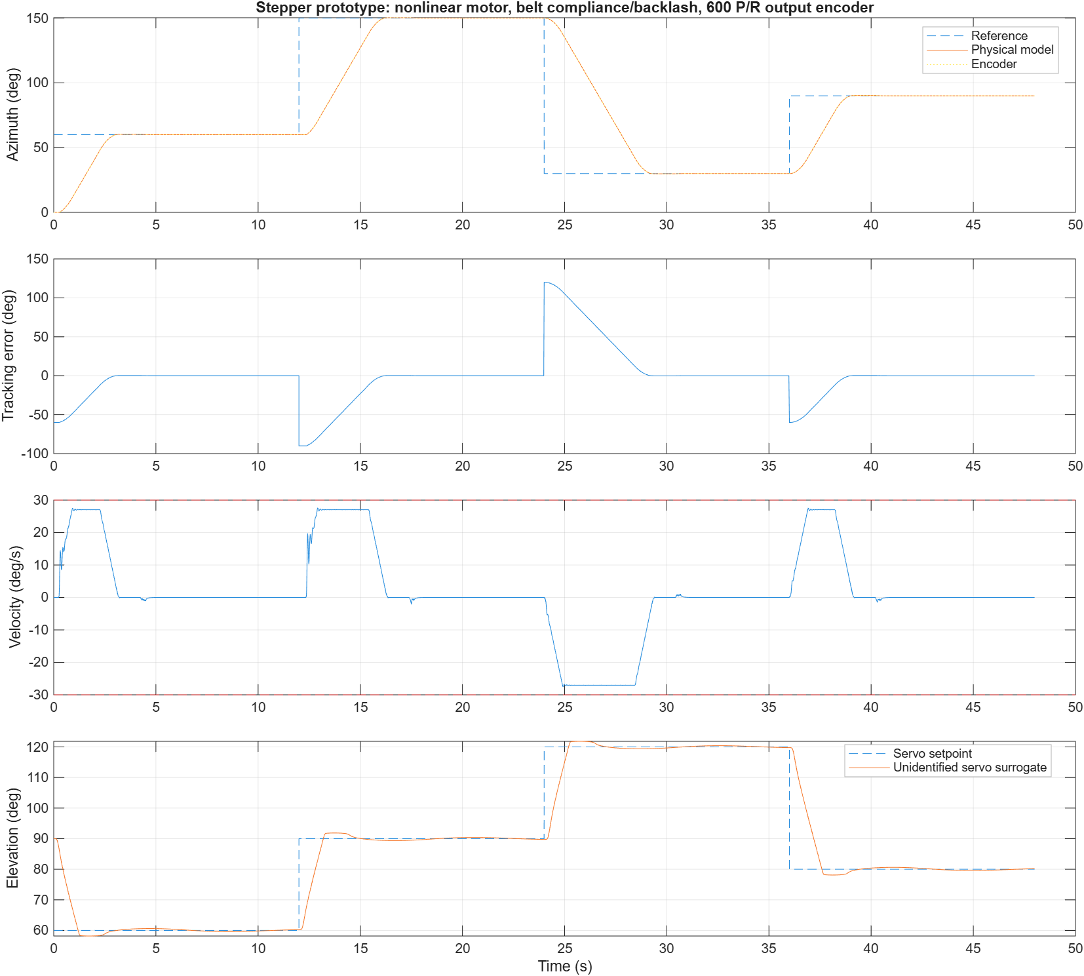
Simulation/results/prototype_tracking.png
