TuanLinh05/antenna-fuzzy-control/Simulation/results/simulink_model.png

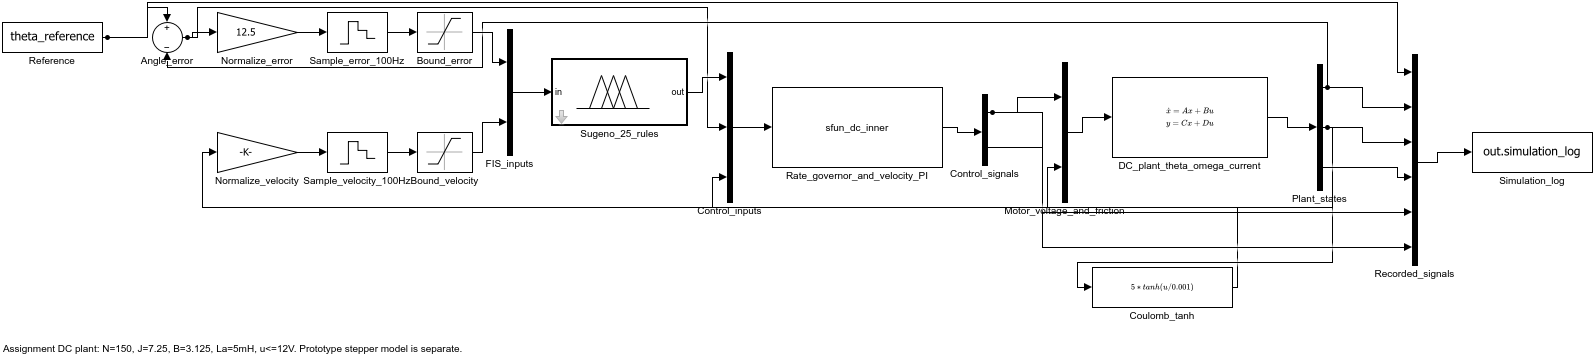
Simulation/results/simulink_model.png
