TuanLinh05/antenna-fuzzy-control/Simulation_V5/results/v5_cad_in_matlab.png

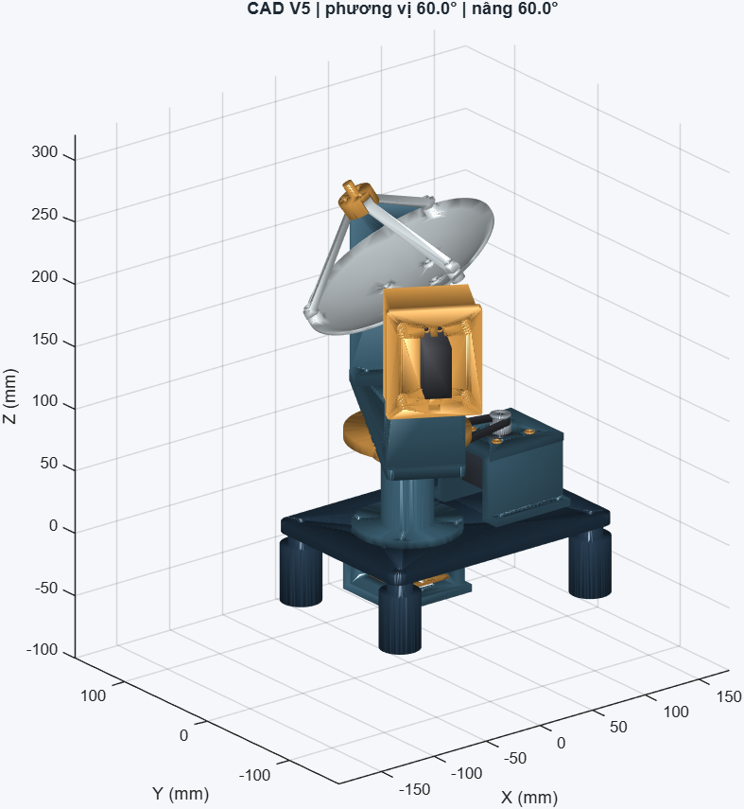
Simulation_V5/results/v5_cad_in_matlab.png
