TuanLinh05/antenna-fuzzy-control/Simulation_V5/results/v5_calibration_demo.png

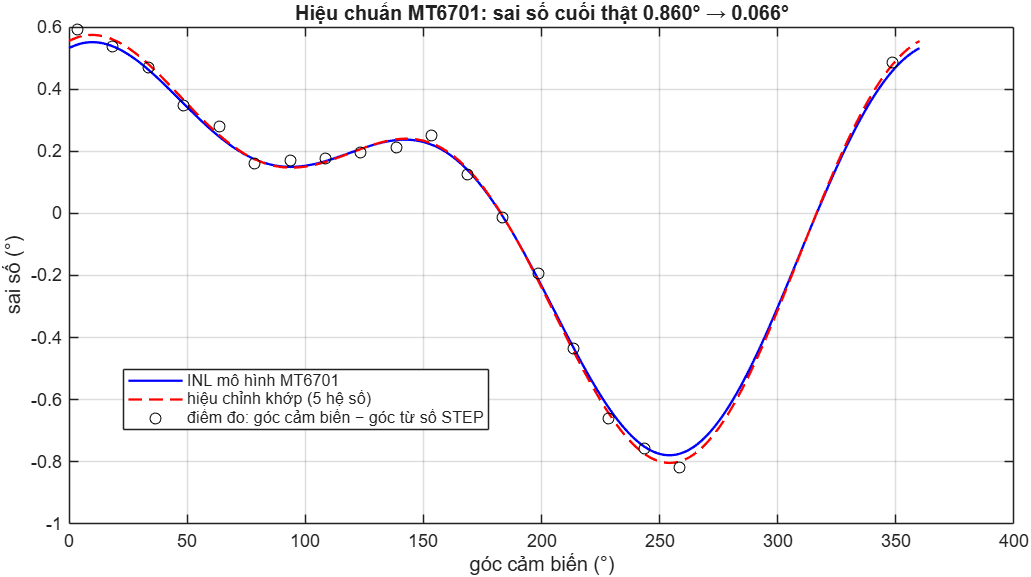
Simulation_V5/results/v5_calibration_demo.png
