TuanLinh05/antenna-fuzzy-control/Simulation_V5/results/v5_compare_controllers.png

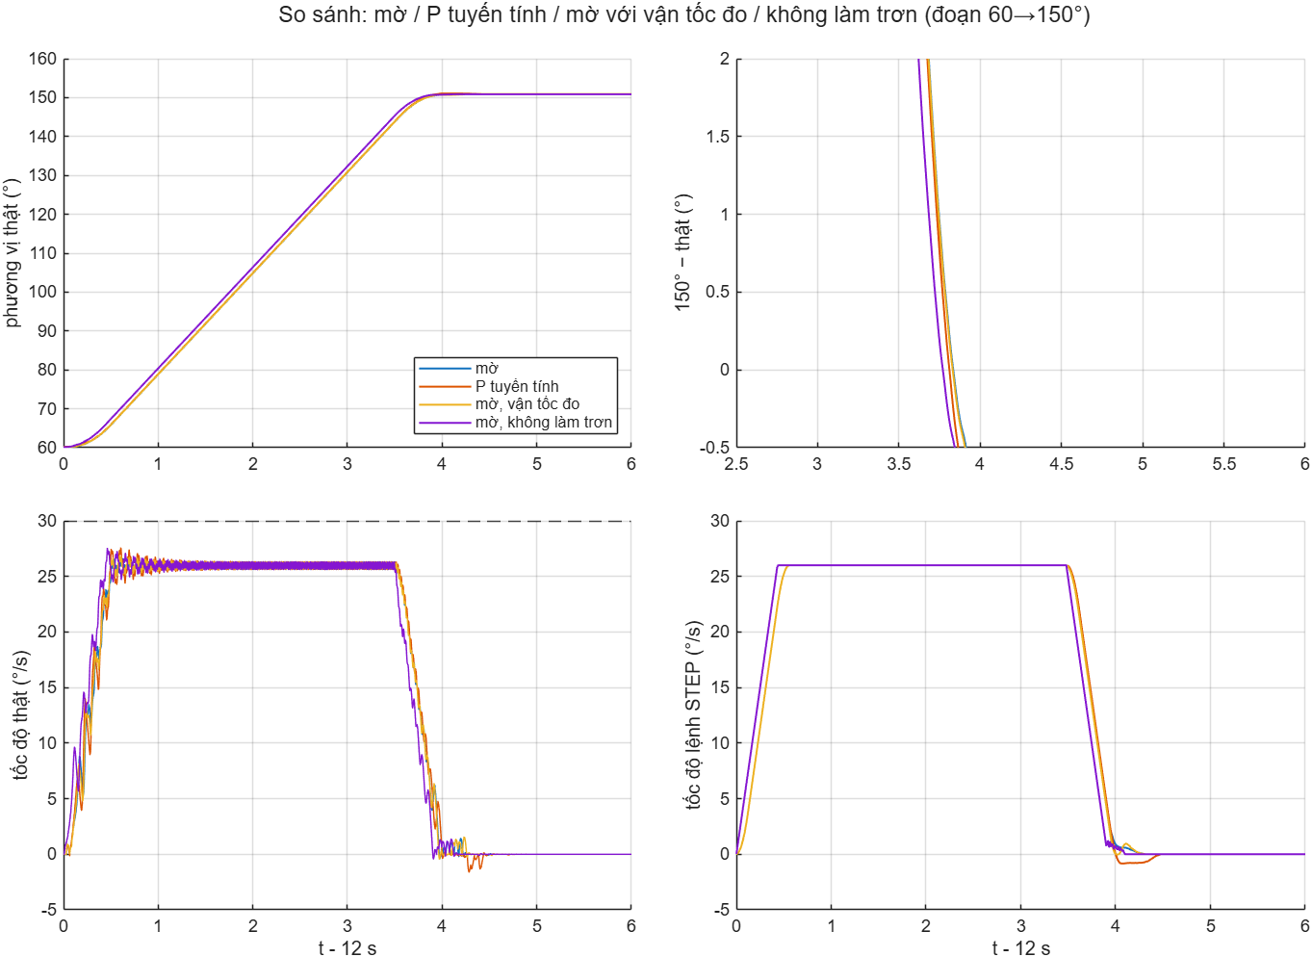
Simulation_V5/results/v5_compare_controllers.png
