TuanLinh05/antenna-fuzzy-control/Simulation_V5/results/v5_faults.png

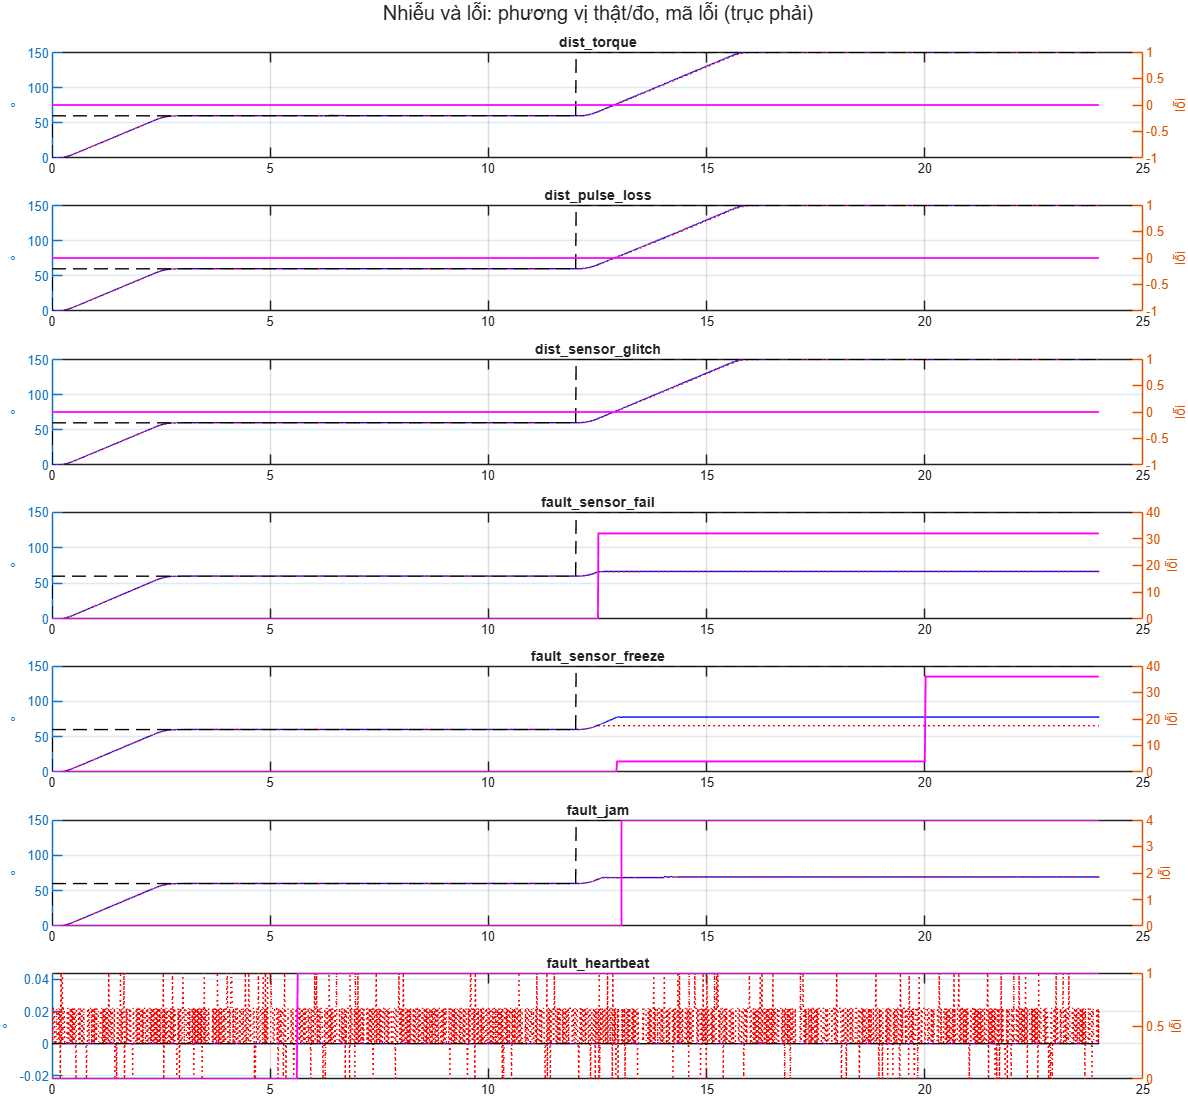
Simulation_V5/results/v5_faults.png
