TuanLinh05/antenna-fuzzy-control/Simulation_V5/results/v5_fuzzy_surface.png

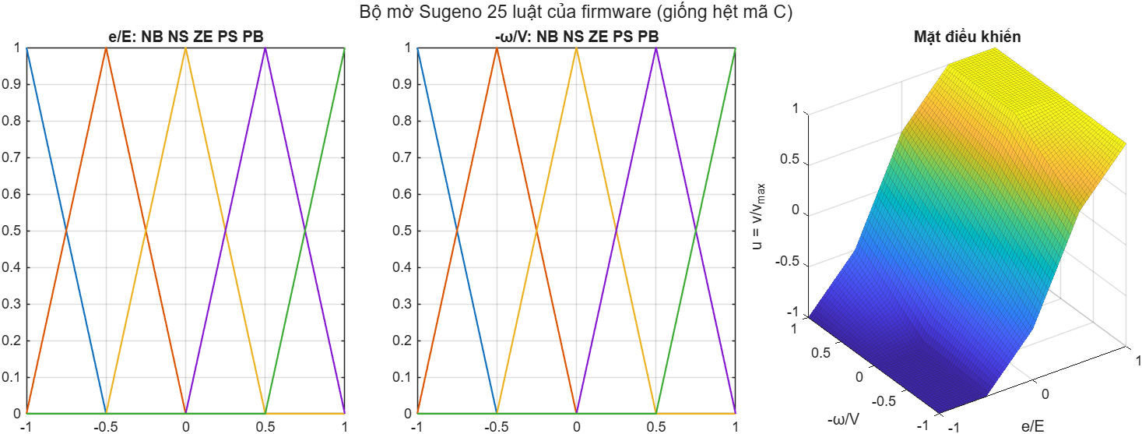
Simulation_V5/results/v5_fuzzy_surface.png
