TuanLinh05/antenna-fuzzy-control/Simulation_V5/results/v5_simulink_model.png

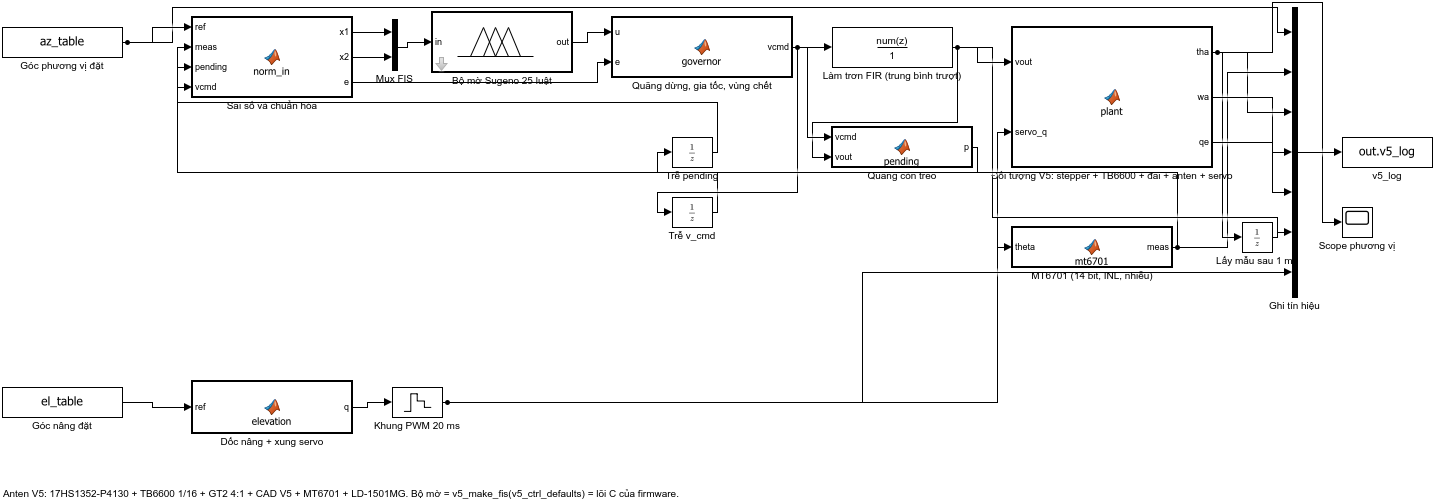
Simulation_V5/results/v5_simulink_model.png
