TuanLinh05/antenna-fuzzy-control/Simulation_V5/results/v5_simulink_vs_script.png

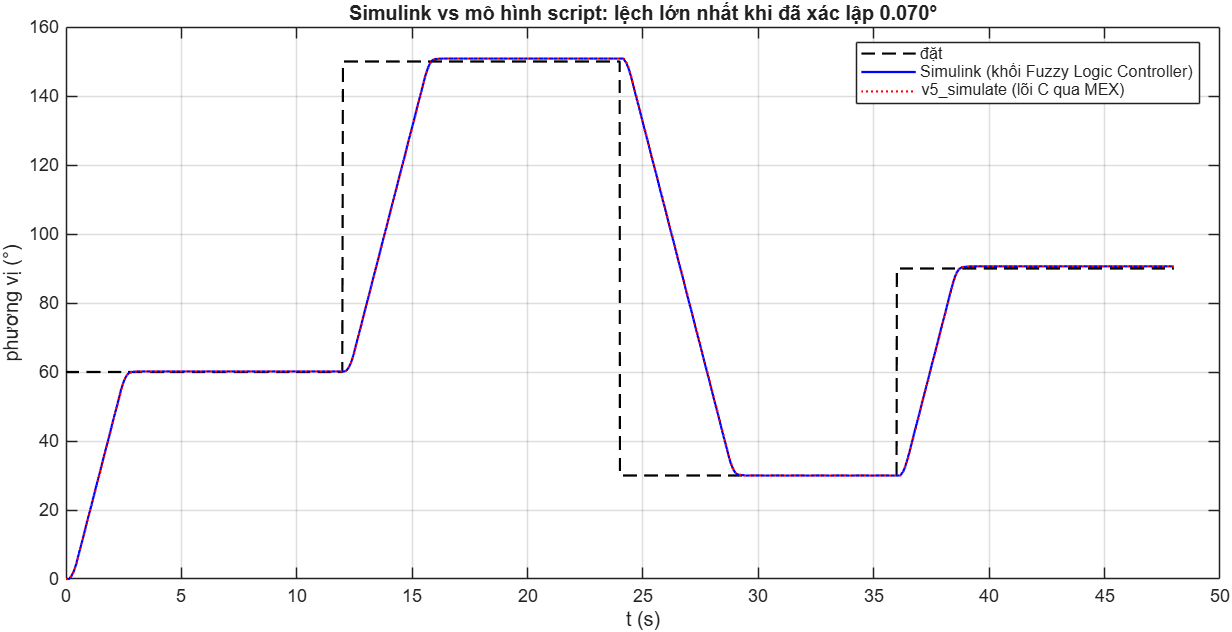
Simulation_V5/results/v5_simulink_vs_script.png
