TuanLinh05/antenna-fuzzy-control/Simulation_V5/results/v5_track.png

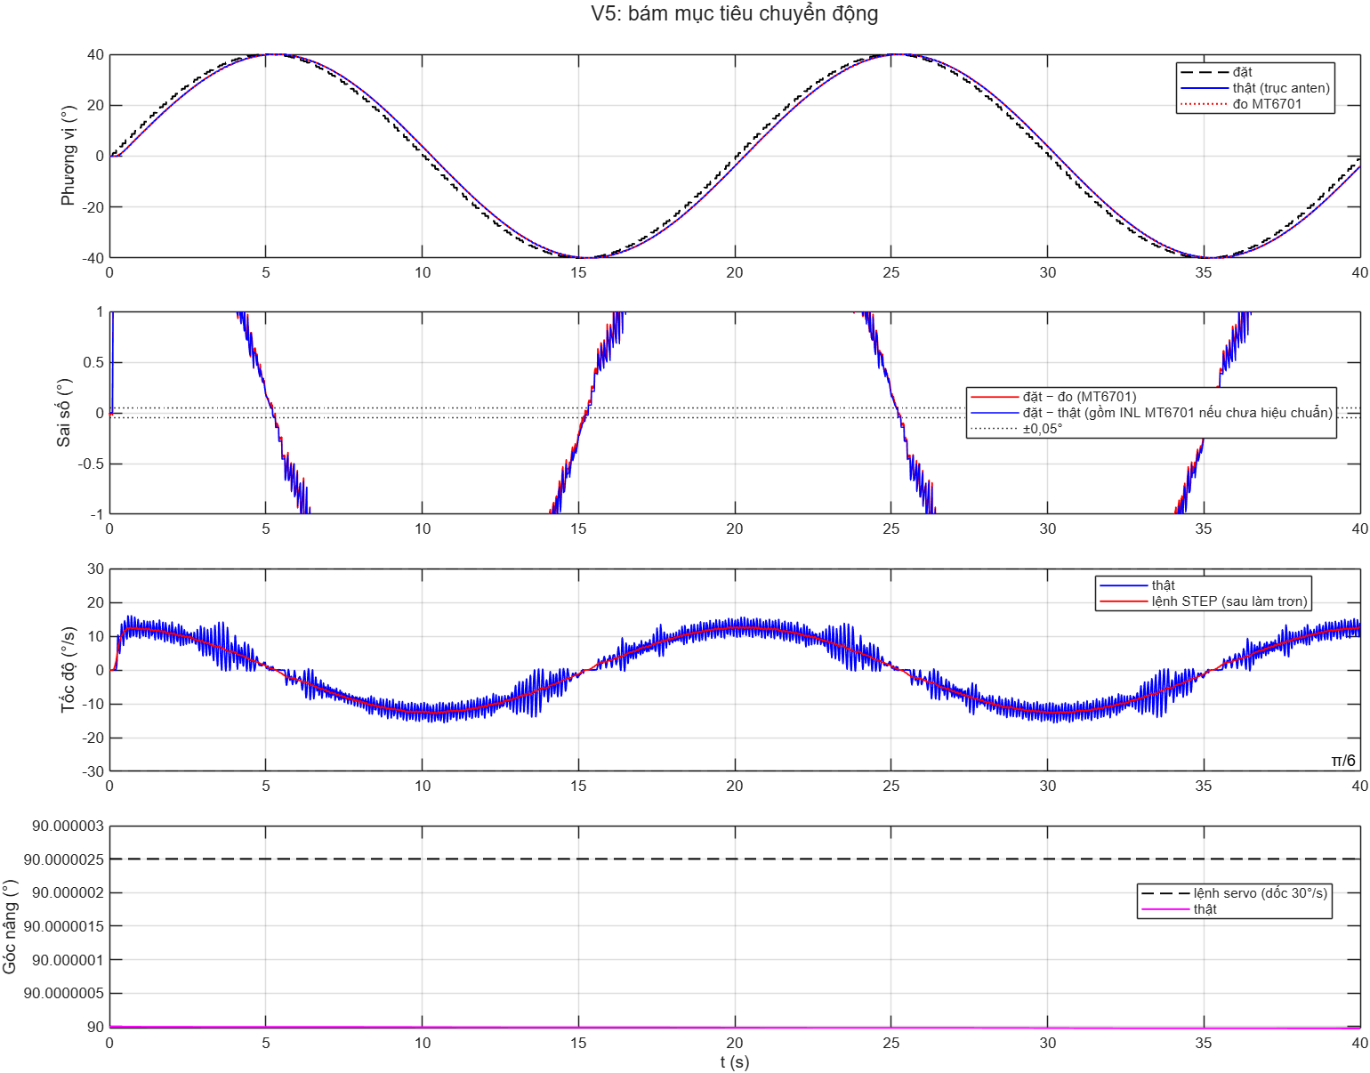
Simulation_V5/results/v5_track.png
